pirorin215/btclock/DEVELOPMENT_BACKGROUND.md

# btclock 開発経緯：なぜこのプロジェクトを作ったのか

バイクに搭載する時計に求められるものは何か？
「正確な時間を表示し続けること」という極めてシンプルな要求ですが、市販品や一般的なアプローチにはバイク特有の多くの課題がありました。本プロジェクトは、開発者が繰り返した失敗と、そこから得られた妥協のないこだわりから誕生しました。

---

## 1. 既存のバイク用時計に対する不満と失敗の歴史

### 失敗①：常時電源（バッテリー直結 12V→5V）によるマイコン永続化
一般的なアプローチとして、「イグニッション連動の5Vだけでなく、バッテリーから常時12V（5V変換）を引き込んで時計を永続化する」という方法があります。

私も以前、キーONでLED表示を点灯させ、時計補償用（バックアップ用）に常時電源を引く仕様の市販時計を使用していました。しばらくは快適に使えていましたが、たまにしかバイクに乗らない私にとって、この仕様には致命的なデメリットがありました。微弱な待機電流であっても、長期間放置されることでクロスカブの鉛バッテリーが過放電を起こし、バッテリーの復旧（あるいは交換）に多大な労力を費やすことになったのです。

**「時計のためにバイクのエンジンがかからない」などということは絶対に避けるべき本末転倒な事態です。** 私はその時計を取り外し、その場でジャンク箱へ本当に投げ入れました。

### 失敗②：内蔵バックアップ電池による時刻の永続化
次に試したのは、内蔵電池（コイン電池など）で時刻データのみを保持し、画面はキーONで点灯するタイプのものでした。

今度はバイク自体のバッテリー上がりこそ回避できたものの、数年後に内蔵電池が寿命を迎えました。さらに悪いことに、電池が錆びついて端子を腐食させ、本体ごと使用不能になってしまいました。また、この手のクォーツ時計は数ヶ月で数分の狂いが生じるため、定期的な時刻合わせの手間もストレスでした。

### 失敗③：市販の電波時計
それならと、市販のバイク用電波時計を導入してみました。しかし、今度は「日中の視認性」に問題がありました。液晶が暗すぎて、昼間の走行中にはほとんど時刻を読み取ることができませんでした。そして電池が切れた時、「市販品には本当に満足できるものがない」と確信するに至りました。

---

## 2. 自作への道：初代「GPS-USB時計」

これらの失敗を踏まえ、「10年はノーメンテナンスで動き続けるバイク用時計」を目指して自作したのが、**GPSで時刻を自動修正し、イグニッション連動のUSB電源のみで動作する7セグLED時計**です。

- **常時電源を使わない（イグニッション連動）**：バイクのバッテリーを絶対に上げない。
- **二次電池（内蔵バックアップ電池）を使わない**：電池交換の手間をなくし、液漏れや錆による故障を完全に防ぐ。
- **GPSによる自動時刻合わせ**：起動時にGPS衛星から正確な時刻を取得するため、手動の時刻合わせが不要。
- **7セグLED表示**：日中でも圧倒的な視認性。

このデバイスは、その後**6年間ノーメンテナンス**で動き続けています。

---

## 3. btclockプロジェクトへの進化：本プロジェクトの存在意義

初代GPS時計は素晴らしいものでしたが、以下の新たな課題や改善点が見えてきました。

1. **GPS測位の時間と場所の制限**：ガレージ内や高架下、あるいは起動直後や曇りの日はGPS信号を掴みにくく、同期までに5分以上かかることもある。
2. **日中の視認性の向上**：ePaper（電子ペーパー）を採用することで昼間も見やすくしたい。

そこで、後継プロジェクトとして立ち上げたのがこの **`btclock`** です。

### 本プロジェクトの設計思想（大前提）
本プロジェクトでは、以下の2点を絶対に譲れない大前提として設計しています。

* **「バッテリー直結（常時電源）は行わない」**
* **「二次電池（バックアップ電池）は使用しない」**

### `btclock` で採用したアプローチ
- **Bluetooth Low Energy (BLE) によるスマートフォン連携**
  GPSの代わりに、現代の誰もが持ち歩いているスマートフォンのBluetoothを利用します。イグニッションONで起動したデバイスが、バッグやポケットの中にあるスマートフォンのアプリと自動的に接続し、数秒でミリ秒精度の正確な時刻に同期します。
- **ePaper (電子ペーパー) の採用**
  超低消費電力で、直射日光下でも紙のようにくっきりと見えるePaperを採用することで、「昼間に見えづらい」問題を完全に解決します。
