pirorin215/btclock/TODO.md

# btclock TODO

## 残課題

（現在なし — v1.4.9 様子見は 2026-10-31 にクローズ・完了済み参照）

## 保留

## 完了済み

### 2026-10-31
- [x] **v1.4.9 運用様子見をクローズ**(2026-10-31 ユーザー判断「再発しなさそう」) — スキャン沈黙の再発は観察されていない。**v1.4.10(スキャン停止放置の防御修正: bonded解決空時の10秒定周期再試行+health check 1分毎の「未接続&スキャン停止」検知)は 2026-10-29 14:09 /apk/ 配信済みのまま未適用・再発したら適用で復旧**(Bluetooth OFF/ON でも可)。付随メモ: 2台同時広告時の接続先選択は未観察(設計上どちらか1台に繋がる)・RSSIスライダーの負値保存は符号問題なし(10-29 確認済み)・旧 `target_device_name` は DataStore 残留のまま(未読・害なし)

### 2026-10-29
- [x] **BTClockMob v1.4.9 接続先デバイス選択の廃止・自動接続専用化**(ビルド済み・実機確認待ち) — 自転車/バイクを交互に使うたびメイン画面プルダウンで接続先を手動切替していた問題の解消。プルダウン・設定画面のデバイス選択ラジオ・`TARGET_DEVICE_NAME` 設定キー・`BleScanServiceManager.targetDeviceName`・bonded 直接接続ショートカット(rssiDisconnectPending/lastScanRssi を含む)を削除し、スキャンフィルタを常に「ペアリング済み全 BikeClock- デバイスのOR条件」+「スキャン発見経由の接続のみ」に統一。根拠: 自転車とバイクに同時乗車はない=広告しているのは乗っている乗り物の1台(バイク版はイグニッションOFFで電源なし・cycleclock は切断後1分で System OFF)で、スキャン経由接続は v1.4.x の RSSI 接続しきい値フィルタが必ず通る。ヘッダーは接続中デバイス名(または未接続)表示のみに簡素化。乗降ログはデバイス区別フィールドなし(ride-*.jsonl)のまま=将来乗り物別集計が必要になったら別途

### 2026-10-25
- [x] **BTClockMobにRSSI リンク品質管理**(v1.4.4・端末適用済み・**実機フルサイクル確認済み**: 接続→弱電波(-90dBm)で切断→近接で再接続。時計の接続LEDでユーザー確認) — 自転車レーダー gardia_radar と同じ「RSSI 信号強度での切断/接続制御」を**アプリ側のみ**に実装。**導入動機**: コンビニ/マクドナルド等で駐輪場から移動先が近いと BLE が切れず、接続中=乗車扱いで乗降データが不正確になる実害が 1 ヶ月続いた(レーダー側では RSSI 制御で切れていた)。電力よりもデータ品質の問題が本線。しきい値はアプリのスライダーで調整可なので、マイコン差分(BT電波性能)の調整は実運用で行う・様子見中①接続時フィルタ: スキャン発見時の RSSI が接続しきい値(デフォルト -80dBm)未満なら接続スキップ+再スキャン継続 ②接続中の自動切断(設定 ON/OFF・デフォルト OFF): 5秒ごとに readRemoteRssi、切断しきい値(-90dBm)未満が判定回数(3回=15秒)連続で forceDisconnect ③設定画面に「RSSI設定」セクション(しきい値スライダー×2+判定回数) ④MainScreen ヘッダーにリンク品質の色分け dBm 表示。実装は `BleConnectionManager`(判定)+`BleRepository`(RSSI読み取り)・deviceFoundFlow を `Pair<BluetoothDevice,Int>` に拡張。既存の死リンク検知(SYNC_FAIL_LIMIT)と独立。**ファーム側への実装は誤解→v0.4.24 はリバート済み(cycleclock は v0.4.23 のまま・コード変更なし)**。修正履歴: ①v1.4.1 ヘッダーRow幅不足で RSSI 表示が切れる(デバイス名を可変幅+ellipsis) ②v1.4.1 切断後の即復活: 自動再接続が bonded 直接接続で RSSI フィルタを通らず→RSSI 切断直後は bonded 直接接続をスキップしスキャン発見時に品質を再判定 ③v1.4.2 スキャンレート制限対策: 「スキップ→1秒後再スキャン」が Android の startScan 制限(30秒間5回)に当たりスキャン沈黙→gardia_radar 戦略を移植(スキャン開始 6 秒スロットル+onScanFailed 指数バックオフ) ④v1.4.3 スキャンの `CALLBACK_TYPE` を FIRST_MATCH→**ALL_MATCHES** へ(gardia_radar と同一。FIRST_MATCH はフィルタに最初にマッチした 1 回だけしか報告せず、スキップ後の発見が二度と来ない=「近づいても再接続されない」の第 1 原因) ⑤v1.4.4 発見時の接続許可に **Error 状態を追加**(forceDisconnect は Error のまま残すため、Disconnected のみのチェックだと切断後の発見を「Already connected」で捨てる=第 2 原因)。**設計上の確認事項**: cycleclock は切断後 1 分で System OFF(アドバタイズ停止)なので、RSSI 切断後は時計が寝て近づいても繋がらない=正しい挙動(喫茶店問題の解決)。再接続は振動起床→アドバタイズ→アプリが拾うフロー。しきい値の実運用調整はユーザー実施中(切断 -80/接続 -75 でテスト)・RSSI は両端マイコン(BT電波性能)で変わるため gardia_radar のデフォルト値は初期値

### 2026-10-12
- [x] **BLE分割転送の実装**(cycleclock v0.4.23 + BTClockMob v1.3.0・実機E2E確認済み) — 単一Write 244B制約の解消。プロトコル: 1個目 `NOTIFY:app=<名前>/<総数>\n<パート1>` + 続き `NOTIFYADD:<パートN>`(片方向・Ack/タイムアウトなし・ファームはRAM組立・総数最大8)。ファームは受信バッファ200B→**512B**(日本語約170文字)へ拡大し、能力probe `GET:features`(`OK:features:notifychunk:512`)を追加。**非対応機はprobe失敗で自動的に従来の単一Write**(バイク版ESP32への影響なし)。アプリ側: 接続毎にprobe(BleOrchestrator startFullSync)→`NotificationSplitter` で240B以内・UTF-8境界安全に分割→逐次送信。スライダー上限100→160文字。実装中の不具合1件: Orchestratorの応答ルーティングに FETCHING_FEATURES を追加し忘れprobeがタイムアウト→追加で解消。E2E実測: 88文字(264B)通知が `NOTIFY:app=X/2`(207B)+`NOTIFYADD:`(57B)で60ms間隔に到着→完全組立→3ページ表示。併せてファーム/アプリ双方の UTF-8 末尾トリムの境界バグ(切り詰め境界がCJK文字境界と一致すると1文字余分に削る・60→59文字の原因)を修正。バイク版(bikeclock_esp32)は未対応のまま(動作に影響なし・将来probeに対応させれば分割の恩恵を受けられる)
- [x] **v0.4.22 自動上書き表示中のページ送りregression修正**(ビルド済み/実機書込済み) — ユーザー実機報告「自動上書き表示中はFUNC押下でフラッシュするだけ」を実機ログで特定: v0.4.21が再入判定に使った ep_drawnMode は、時計上書き表示中も updateEpaperDisplay のTIMEモード入口で**毎ループパス TIME に戻る**(通知ビュー描画時に NOTIFICATION を設定しても次パスで clobber)ため、notifyPageAdvance の再入判定が誤発火し毎回1ページ目へ戻っていた。モード2では非TIME分岐が先に return するため無事だった(ログで裏取り済み)。修正: 専用フラグ `ep_notifyOnScreen`(描画時に立てる・invalidateViewCache と詳細/詳細大への遷移で解除)に置換し、無意味化していた自動上書き側の ep_drawnMode 代入は削除。adb cmd notification post で投稿した60文字テスト通知(2ページ構成)で検証
- [x] **表示されている「文がシャッフルされて見える」件の切り分け(ファーム無罪)** — ユーザー報告「1ページ目が『今から喜ぶのは〜』で始まり2ページ目に『ラバルのやつが』が出る」。実機ログの受信本文を確認したところ、**アプリが送った時点でその並び**(fastrecmob 通知の title+body 結合 = 動画タイトル前半 + チャンネル名部分 + 別断片、180B で切断済み)。ファームのページ分割・描画は受信テキストに対して正しく、表示順の怪しさはアプリ側の結合順と本文内容に起因
- [x] **通知転送の実効上限を実測確定**(adb cmd notification post で5段階テスト) — Pixel 10 へワイヤレス adb 接続し `cmd notification post -S bigtext`(実通知パス=BikeNotificationListener の切り詰めを通る)で送信、ファームログで受信値を確認: **日本語は 60文字(180B) が上限**(60文字→180B 無切断・100文字→177B/59文字にサイレント切断。スライダー100文字は CJK には効かない。ASCII は 100文字=100B でスライダー上限が効く)。60文字→5行→**2ページが現プロトコルの最大**(MTU 247→Write 244B→ヘッダ差引き本文180B の設計上限)。副次発見: アプリ truncateUtf8 は 180B 境界が CJK 文字の完全一致になる場合も1文字余分に削る off-by-one(60→59文字)。監視は nohup consolelog(/tmp/cc_console.log)で恒久化。今後の拡張は分割転送プロトコル(アプリ+ファーム改修)のみ
- [x] **通知ビュー再入時の先頭ページ復帰**(v0.4.21・ビルド済み/実機書込済み) — v0.4.20では前回の読書位置(ページ)が保持され、再び通知ビューを開くと最終ページから出るというユーザー指摘を修正。他ビューからの再入(モード2再選択・時計上書きの再表示)では ep_drawnMode != NOTIFICATION を根拠に先頭ページへ戻す。時計上書き表示が画面に出ていることを ep_drawnMode=NOTIFICATION で示すようにし(単一ページ通知の状態で FUNC→モード2 した際の無駄なフル更新も自然に抑制)、ページ送りの直接描画との区別がつく。実機書込済み・シリアル起動ログで `Firmware Version: 0.4.21 (Oct 12 2026)` 確認
- [x] **通知本文の見切れ原因の特定(アプリ側の仕様だった)** — ユーザー報告「2ページ目で切れる」。ファームの200B上限ではなく **BTClockMob 側で2段階の切り詰め**が発生していた: ①設定「通知転送の最大文字数」デフォルト **47文字**(超過時は末尾に「＞」を付与・スライダー10〜100文字で変更可・`DEFAULT_NOTIFICATION_MAX_CHARS`) ②UTF-8 **180B** ハード上限(`MAX_BODY_BYTES`・"NOTIFY:app=<pkg>\n" ヘッダ込みでMTU 247に収めるため。日本語≈60文字が実効上限・こちらは「＞」なしのサイレント切断)。対処: ページング運用ではアプリ設定のスライダーを上げる(日本語主体なら実効上限の60文字・ASCII混在なら100文字まで有効)。デフォルト値の引き上げ(アプリ改修)は未実施
- [x] **通知ビューのページ送り**(v0.4.20・ビルド済み/実機書込済み・ユーザー動作確認) — ePaper が狭く長文通知が見切れる問題への対処。FUNC クリックの割当を競合させないため「ロールオーバー方式」を採用(専用キー増設案は D3 が BMI160 I2C 予約のため見送り): **通知ビュー(モード2・時計への新着自動上書き)表示中は FUNC クリック=次ページ**、最終ページで合流(モード2=そのままモード順送り/時計上書き=通知を閉じて時計へ=読了)。1ページに収まる通知は従来どおり FUNC=モード循環。実装: 旧 drawWrappedText を行境界生成(wrapTextLines)+行範囲描画(drawTextLines)に分解し ep_notifyPage の範囲のみ描画、複数ページ時は下端 14px に「n/m」帯を確保(帯分は行数計算から予約・単一ページは全高のまま旧表示と同一)。ページ送りのたびに 30 秒通知ウィンドウと 10 秒自動復帰を延長。**時計への自動上書き表示も新着受信(seq)で再描画するよう拡張**(旧実装は表示中の新着が画面に反映されず)。Flash 84%/RAM 10%

### 2026-10-07
- [x] **System OFF 22µA 達成(BSS138 ローサイドで ePaper+WS2812B 統合切断)** — 実機に BSS138+100kΩ を組み込み、**ePaper の GND と WS2812B の GND を同じ BSS138 の D へ共有接続**(VCC/VDD は 3V3 直結のまま)。360µA→**22µA**(94% 減・安定まで数十秒かかるのはコンデンサ放電で正常)。動作確認: LED 点灯・通知演出・ePaper スリープ残画・振動復帰すべて正常。待機電流の内訳: XIAO 11µA+ePaper 残存 ~8µA+WS2812B 残存 ~3µA。**懸念だった DIN の 10kΩプルダウン経由の迂回リークは実測でほぼ出ない**(WS2812B の DIN 入力が高阻抗のため)。ファームは v0.4.19 のまま(D1=HIGH 制御が v0.4.10 から生きており BSS138 と同一論理)。電池寿命: 年間 ~900mAh(毎日乗車想定)=3 年超
- [x] **360µA の切り分け(WS2812B が主犯と判明)** — BSS138 組込直後の実機が 360µA までしか下がらず。①ローサイドの構造的限界(VCC 残存×信号線迂回)を疑ったが、②**WS2812B の VDD(3V3 直結)を外すと 22µA** まで下がり主犯確定(~330µA スタンバイリーク)。ePaper のローサイド残存は ~17µA でほぼ完璧に機能していた。→ GND 共有接続で解決
- [x] **BSS138 単体動作試験(マイコンなし)+ kento 資料化** — 安定化電源 3.3V+負荷 500Ω+100kΩプルダウンで 3 状態測定。**RDS(on) 実測 ≈2.6Ω**(ON 時 VDS=17mV・6.57mA・規格 3.5Ω@4.5V 以内)で合格・採用確定。フル更新 50mA でも GND 浮き 0.13V で SSD1680 動作範囲内。教訓: ①ワニ口クリップ 1 個の接触不良で数十Ω乗る(mV 級測定は全固定+プローブはリード根元直当て) ②ゲートジャンパ接触不良は「部分導通」という紛らわしい症状になる(先に G-S 電圧を疑う) ③**実機組込前に単体で足場を作る=昨日の TPS22810 敗北(基板に組んだ瞬nectに何が悪いか分からなくなる)の再発防止**。記録: `~/www/kento/bss138-epaper-lowside-switch.html`(実機組込配線・AO3401A 移行手順込み)
- [x] **部品台帳の写真棚卸し(実店舗購入品の取り込み)** — Pixel 撮影→NAS(`/data/share/photos`・Syncthing 同期)→rsync→**vocr 識別→13 品目登録**(MCP3008×2/MCP23017/MCP23S17/MCP23S08/74HC595/AE-XCL103-3V3/AE-SPU0414/GY-GPS NEO-5M/LCD1602 キット/ブザー 3-24V/XY-UP/Azoteq TPS43-201A/シリカゲル・seed076-088・台帳 89→102 品)+BSS138 ×8(seed075)。不明 3 件はユーザー指示で未登録。フローは手順化されメモリ保存済み(次回「棚卸し」で即回せる)

### 2026-10-06(2)
- [x] **v0.4.18 シリアル調整コマンド実装**(ビルド済み・書込待ち) — WS2812B の常亮色をシリアルから調整する調整段階専用UI: `led R G B`(即変更+BLE未接続でもプレビュー点灯)/`ledsave`(InternalFS `/ledstrip.bin` へ永続化)/`leddefault`(保存削除・既定値へ)/`ledflash R G B`(演出プレビュー)/`ledinfo`。コマンド受信のたびにスリープ判定を延長(未接続の調整作業が1分System OFFに潰れない)。シリアル処理はloop文脈のみ(InternalFS書込みをBLEコールバックから触らない設計を維持)。Flash 84%/RAM 10%
- [x] **WS2812B 点灯確認**(ユーザー報告・v0.4.16/17) — 配線(DIN→D6+10kΩプルダウン・VDD→3V3分岐)で点灯・三色制御確認済み
- [x] **v0.4.16/17 WS2812B 装飾LED 実装**(ビルド済み・配線待ち) — `cycleclock_ledstrip.ino` 新設。VDD は XIAO 3V3 から分岐(3.3V 駆動・System OFF 中も通電のため DIN 10kΩプルダウンで消灯維持)。D6 は起動シーケンスの早い段階で LOW 出力へ確定(`setupLedStrip()` を `setupEpaper()` より先に呼び DIN 浮き誤点灯防止)。送信は Adafruit_NeoPixel(nRF52 は NRF_PWM+EasyDMA・SoftDevice 割込でもビット時序が壊れない・~/dev/Arduino/libraries 既存を使用)。演出は loop 駆動の非ブロッキング状態機。System OFF 直前は消灯ラッチ送信→D6 INPUT 化。Flash 83%/RAM 10%
- [x] **v0.4.11 実装・ビルド**(書込待ち) — 誤起動回数(フラッシュ永続化)+D0短絡回数(processWakeSwitch 押下開始と同タイミング・BT接続中のみ)+詳細画面表示。Seeeduino nRF52 では InternalFS は `InternalFileSystem.h`(InternalFileSytem ライブラリ・bonding と同じ)/File 型は `Adafruit_LittleFS_Namespace::File`/open モードは `FILE_O_READ/FILE_O_WRITE` を使う(ビルド教訓)
- [x] **喫茶店問題の原因特定**(ユーザー推理による) — 「スマホが近くに居ると cycleclock が寝ない」問題。TR70(Gardia)が喫茶店で「切断されてた/戻ると再接続」に見えたのは TR70 の仕様ではなく、自作ガリアアプリ(`~/dev/Android/gardia_radar`)の **RSSI しきい値接続制御**(デフォルト -80dBm 未満で接続スキップ+再スキャン)だった。解決策=BTClockMob に同じ仕組みを移植(残課題へ)
- [x] **TPS22810 ノイズ問題の切り分け完了** — v2.2d(連続フル更新+D1監視)で EN(D1)は最後まで HIGH=SPI/MISO 競合説を否定。RON@3.3V=83mΩ(datasheet)で能力問題も否定→チャージポンプのスイッチングノイズが ePaper フル更新と相性不良と結論。VOUT 10µF 添加で初回表示まで改善したが2回目以降ダメ→撤退を決定(P-ch MOSFET へ)

### 2026-10-06
- [x] **通知ビューのアプリ名行廃止**(v0.4.11・ビルド済み/書込待ち) — アプリ名の常設先頭行(16px+本文y=24開始)が本文エリアを圧迫し4行目が切れるため廃止。本文のみを y=0 から全画面描画し、全文が4行収まるように。本文が空の時だけアプリ名を代替表示(両方空なら従来どおり「通知なし」)。g_notificationApp はログ用として維持(BLE送信側・アプリ互換は無変更)
- [x] **System OFF 0.5mA 問題 完全解決(TPS22810 ロードスイッチ導入・実測11µA)** — µAテスタ初実測で発覚した待機電流0.5mA(推定電池寿命60日)を11µA(約31年・自己放電支配)まで削減。切り分けの経過: ①本番v0.4.9=0.5-0.6mA ②最小ファーム+hibernate+信号Hi-Z化=630µA(効果なし) ③ePaper VCC外し=27µA ④新品XIAO裸=11µA(基準値) ⑤**TPS22810でePaper VCCをGPIO制御→11µA(完全解決)**。真因は ePaper モジュール基板(信号線プルアップ+レベルシフタ)への常時給電で、ファームウェア(hibernate・Hi-Z化)では断てなかった。**教訓: ①SOT-23-6 の GND 足が欠けると中間電圧(1.25V/2.4V)が出る ②配線の品質自体がµA級のリーク差(27µA→11µA)を生む ③µA 測定はテスタのバイパス方式(テスタ並列にショートリード・起動時のみバイパス)が実用的**
- [x] **診断ファーム `cycleclock_diag/` で切り分け実施** — v0.4.90(本番コピー+10秒スリープ)→ v2(最小3秒スリープ)→ v2.1(信号ピンHi-Z化)→ v2.2(TPS22810制御)→ v2.2b/c(タイムスタンプ+D1 readbackログ+USB列挙待ち2.5s)→ HOLD版(D1=HIGHで永久待機=電圧測定用)。新作ボード(現行)は SoftDevice 未焼きで arduino-cli DFU が不通→UF2(uf2conv)で sd+bootloader 0.6.2+s140 7.3.0 を焼いて解決。テスタ(AN8008)運用ノウハウ: µA系レンジ(VΩ端子)は負担電圧が大きく起動電流でマイコンがブラウンアウト→バイパス方式で回避。6000µAマニュアル固定でも起動不可(実測)

### 2026-10-05
- [x] **振動センサー調整用テストファーム `cycleclock_vibetest/` 作成**(ビルド済み・書込待ち) — D0 導通(振動パルス)でオンボード緑 LED 点灯・導通解除後 1 秒で消灯(連続振動中は点きっぱなし)。検出は本番(v0.4.8)と同じ GPIOTE 割り込み(CHANGE で両エッジを受け導通幅 µs 測定も追加)+Serial 統計ログ(300ms 窓のパルス数・導通幅・5 秒 HB)。BLE/ePaper/System OFF は意図的に非搭載(調整中に寝ない・USB 駆動推奨)。本番と同じ D0 で調整結果はそのまま転用可。ビルドノウハウ: Serial(USB CDC)の実体は bluefruit.h の依存検出で間接リンクされていたため、BLE なしスケッチでは `Adafruit_TinyUSB.h` の明示 include が必須(無いとリンカで Serial 未定義)
- [x] **v0.4.9 実機確認**(ユーザー確認OK) — ①未同期画面のバージョン表示でv0.4.9を確認 ②BLE接続中は3分無振動でも寝ない ③切断後は無振動3分経過済みなら即System OFF ④D0の2秒導通で寝ない(長押し廃止の確認) ⑤FUNC非TIMEモード10秒自動復帰 ⑥通知30秒表示 ⑦フル更新の体感速度(BW版・ユーザー報告「一瞬で書き換わる」)。書込はUSB経由(3回ともDevice programmedまで成功・シリアル起動ログはCDC再列挙で未捕捉だったため画面で確認)
- [x] **BW版ePaper 実機差替**(2026-10-05・ユーザー実施) — 物理差替完了。フル更新の高速化はユーザー報告「一瞬で書き換わる」で確認。ファーム側はv0.4.9で3色低速前提コード撤去済み(waitPanelIdle 30秒ガード廃止・FUNC自動復帰60秒→10秒・通知60秒→30秒=いずれもbikeclock_esp32と同一)。描画コードにGxEPD_RED等の3色名残は無し(BW駆動のまま)
- [x] **スリープポリシー変更+BW版前提の整理**(v0.4.9・実機確認済み) — ①BLE接続中はスリープしない(checkSleepTimeout冒頭でガード・切断後は無振動3分経過済みなら即System OFF。旧「接続中でも先に切断して寝る」分岐は削除) ②D0長押し2秒の手動System OFFを廃止(測定・テスト用だったが無振動3分放置で代替可) ③System OFF前の解放待ち10秒上限を廃止し導通が解けるまで無期限に待つ(短絡時に打ち切って寝ると即再起床の再起動ループ→ePaperフル更新連発で電池を食うため) ④BW版ePaper前提へ: waitPanelIdle(3色パネルの>10秒フル更新対策ガード)廃止・FUNC自動復帰60秒→10秒・通知表示60秒→30秒(いずれもbikeclock_esp32と同一)

### 2026-10-04
- [x] **振動パルス検出の実機確認**(v0.4.8) — GPIOTE割り込み(FALLING)化で動作確認(2026-10-04・ログ出力を確認)。v0.4.6以前の50msデバウンス・v0.4.7のloopポーリング(約10ms)はいずれも1ms級の導通パルスを取りこぼしていた(起床はDETECTが拾うが延長が発火しない)。SW-18020P自体の感度は「強いショックには確実・微振動に弱い」で、代替素子調査(SW-200D/520D=チルト検知で不適・SW-420=常時mA消費で不適・18010P/15P=バネ式で導通品質良いが微振動感度は下がる実測)の結果、当面現状維持+実走行で様子見。改善するなら異機構2素子のD0並列接続が有望(受動・ゼロ消費のまま)
- [x] SW-18020P 組込 — タクトスイッチと差し替え(D0・結線同じ他端GND)。2026-10-04組込済み(ユーザー実施)

### 2026-09-30
- [x] **FUNC4モード実機動作確認**(v0.4.1・2026-09-29ユーザー確認「バッチリ」) — FUNC4モード循環・FUNCキーでのSystem OFF復帰・起床release分離・60秒自動復帰・未同期画面ver表示
- [x] **v0.4.4 書込と実機確認**(omp整理の取り込み) — ①時計遅れ修正の効果(ePaperフル更新を跨いでも時刻が遅れない) ②通知ビュー先頭行のアプリ名 ③FUNC各モード・FUNC起床が従来どおり。後続のv0.4.8実機確認(2026-10-04)・v0.4.9実機確認(2026-10-05)で包含確認済みとして完了扱い
- [x] **omp simplify差分のレビュー・取り込み**(v0.4.4・ビルド済み/書込待ち) — 実質改善: ①updateTimestamp()一括秒加算+端数繰り越し(旧は1呼び出し最大+1秒・端数破棄で、3色パネルのフル更新>10sのたび時計が数秒ずつ遅れ蓄積) ②通知ビュー先頭行にアプリ名表示(従来ログ専用) ③BLE過大Write(>247B)へERROR応答 ④BLE切断reasonログ化。整理: デバウンス共通化(DebouncedSwitch)・isLeapYear抽出・モード分岐switch化・invalidateViewCache()・コールバック名onConnect化・未使用define削除・LEDコメント実態化。**日跨ぎ走行区間の折り返し表記化はompによる勝手な仕様変更と判定し原状回復**(24時超え表記「22:00〜26:30」=bikeclock_esp32と同一仕様・getRideStartとの共通化を解除)
- [x] **FUNCキーでのSystem OFF復帰**(v0.4.1・実機確認済み) — enterSystemOff のウェイクピン構成にD2を追加(nRF52のDETECTはピンごとSENSE条件のOR・どちらかの導通で起床)。FUNC押下で起床した場合の初回releaseはモード切替としない(起床操作と切替操作の分離・起動時のピン読みで推定)。System OFF前のスイッチ解放待ちをD0/D2両方に拡張(FUNC押しっぱなし放置でも即再起床ループを防止)
- [x] **FUNCモードをbikeclock_esp32と同一の4モード構成へ**(v0.4.0・ビルド済み/書込待ち) — ユーザー要件「bikeclock_esp32とほぼ一緒に(バッテリーピクト追加した形)」。モード1時計/モード2通知(最終受信・手動選択・新着g_notificationSeqで再描画)/モード3詳細(開始/経過/現在日時/電池電圧・esp32のHID行の代わりにバッテリー行)/モード4詳細大(日付/経過/開始〜現在+ピクト・スリープ残画と実体共通のdrawEpaperDetailLarge)。電池詳細・バージョンの独立モードは廃止。起動時刻はスリープ残画と同じ逆算方式(現在−経過)。追伸要件: 未同期画面(同期まで数分見続ける)にver表示を追加
- [x] **FUNCキーを専用GPIO(D2)へ分離**(v0.3.9・ビルド済み/書込待ち) — v0.3.8の押下時間分離(D0中押し0.5-2s=モード切替)は実機で不採用: クリックで反応せず・長押し操作が使いづらく・そもそも走行中は振動が常にD0へ短押しパルスを入れるため「単押し=モード切替」と要件が排他。波形学習で振動/人間を判別する案は論外として、空きGPIOがあるなら分離一択(bikeclockが専用FUNCキーSW8を持っていたのと同じ理由)。D0は純粋な振動ウェイクに戻し、D2クリック=モード順送り(bikeclock同様)・60秒自動復帰と乗車イベント復帰の自己修復は維持
- [x] **FUNCキー機構の移植**(v0.3.8・ビルド済み/書込待ち) — bikeclock の FUNCキー(SW8短押しでTIME/DATE/WEEKDAY循環+5s自動復帰)を cycleclock へ移植。相違点: cycleclock のスイッチは振動センサー兼用のため押下時間を3段階に分離(短<0.5s=乗車イベント/中0.5-2s=モード切替/長≥2s=System OFF)。モードは時計→電池詳細(電圧大表示+ピクト・電圧変化で再描画)→バージョン。60秒自動復帰+乗車イベントで復帰の二重自己修復(振動誤切替の被害を限定)
- [x] **電池表示の閾値・段階スイープ試験**(v0.3.7実機で実施・安電源コールドブート毎) — 3.5V=要充電ビュー/3.6-3.7V=1本/3.8V=2本/3.9V=3本/4.0V=4本/4.1V=5本。設計式(level=(V-3.60)/0.1+1・≥4.00Vで満枠)と0.1V精度内で整合(「4.0V表示で4本」は実出力3.96-3.99V想定)。実18650: 3.77V→2本(計算一致)。ePaper書換の急激な電圧低下にピクトは反応せず安定(BUSYガード+中央値フィルタの効果)。残すは `BATT_DIV_MULT` 校正(ソーラー実機確認と同時)
- [x] **残量表示の中央値フィルタ**(v0.3.7・書込済み。書込はユーザーが手動実施) — 直近5サンプル(5分)の中央値を表示・報告値(`s_battVolts`)に採用。ピクトが表現すべきは「残量」=弛緩電圧で、負荷dipの単発ノイズは無視する設計(実際の放電はゆっくりなので実変更には5分以内に追従)。ログはraw+フィルタ後の両方。v0.3.6のパネルBUSYガードと重ねて二段構え。USB-only電池なし構成では測定自体が無意味な件は仕様メモに記載(Plan BのVBUS検知は未実装・必要になり次第)
- [x] **パネルBUSY中の電圧測定スキップ**(v0.3.6・書込済み) — display()がBUSYタイムアウト(10s)で先に返った後も3色パネルは物理更新を続けるため、直後のloopで走るupdateBattery()が負荷スパイク中に測定してキャッシュを汚染していた(スリープ残画のピクトが時計より低く描かれる一因)。`epaperIdle()`(setupEpaper完了までは常時idle扱い)でBUSY=HIGH中はスキップ。fastrec2の「アイドル時キャッシュ測定」教訓を実装として強制
- [x] **「時計5ピクト→スリープ1ピクト」の原因特定** — 時計はブート時キャッシュ(4.082V・無負荷測定)で描かれ、60秒後の接続負荷下実測(3.70V)がキャッシュされてからスリープ残画が描かれたため。両表示ともその瞬間のBATパッド電圧としては正しい。真因は安電源のCC制限による負荷時電圧崩落(上記残課題)
- [x] **「ピクト1/5なのにアプリ4.08V」の原因判明**(誤動作なし) — デバイス実測は3.69-3.73Vでピクト1本は正しく、アプリ表示は16:56ポーリング(v0.3.4書込直後の4077mV)の古い値が残っていたもの。5分間隔ポーリングがスリープ中に不可能なため更新されず+ePaper残画がスリープ前フレームを保持していた時間差現象。ピクト/GET:batteryは同一キャッシュを参照し常に一致
- [x] **電池ピクトの右下固定+スリープ残画対応**(v0.3.5・書込済み) — 横型から縦型(端子上・バー下から積み上げ)へ変更し画面右下(222,86)に固定。時計画面は乗車時間を右端242→206へオフセット+時計アイコンをcx136→90へ移動して右下に場所を空けた(横型のままだとアイコン+数字+ピクトが右欄176pxに収まらないため縦型化)。スリープ画面(残画)にも同じ位置に描画→System OFF中も翌日まで電池量が見える(「寝てる時こそ観たい」要望)。警告「!」はピクト左に両ビュー共通で表示
- [x] **時計画面の電池ピクトグラム+警告「!」**(v0.3.4・書込済み) — 右欄下段左の空き領域(乗車時間アイコンの左)に横型5段階バッテリー(3.60-4.10Vを0.1V刻み・<3.60Vは0本の空枠・>=4.00V満枠)。3.65V未満でピクト左に「!」(解除3.70Vのヒステリシス・ePaperは点滅不可のため静的マーク)。段階は `batteryLevelPict()`、警告は `batteryWarnActive()` ラッチ。描画は毎分の時計更新に乗る(電圧変化の反映は最大60秒遅れ)。書込直後4.08Vで5本満枠を確認(視覚は安電源掃き試験で要確認)
- [x] **要充電ビューの3.5V実機確認**(v0.3.3) — 安定化電源3.5V駆動で全画面「要充電」が表示されることを確認。過放電防止のためこの全画面状態が必要と判断(ユーザー評価)
- [x] **低電圧通知のePaper表示 実装**(v0.3.3・ビルド済み) — 3.50V以下で「要充電」ビュー(電池アイコン+実測電圧)、3.60V以上で解除のヒステリシス(`BATT_LOW_THRESHOLD_V`/`BATT_LOW_CLEAR_V`)。ビュー優先度は 通知>低電圧>未同期>時計。スリープ時は乗車スナップショットの代わりに要充電を残画化(駐輪〜翌日も警告が見える=充電忘れ防止が主目的)。発報は60秒キャッシュ測定側のラッチ(`batteryLowActive()`)で行い、ADC非接触の設計(lesson: BLEコールバックからのSAADCアクセス禁止)は維持

### 2026-09-27
- [x] **配線組立**(2026-09-27完了) — kentoメモ(`~/www/kento/xiao-ble-solar-tp4056.html`)の組立手順どおり: パネル→IN± / 18650→B± / XIAO電池パッド→OUT±。検品・パネル確認・Rprog・ベンチチェックの結果は未記録(下記実機確認で総合的に判断)
- [x] **スマホ通知のePaper表示**(cycleclock v0.3.2・実機確認済み) — バイク版(bikeclock_esp32 Phase 10/11)と同じ仕組みを移植。アプリの通知リスナーが `NOTIFY:app=...\n本文`(最大200B)を送り通知ビューを表示。これまで表示されなかった原因は3つ: ①コマンド特性が32B固定長で長Writeが届かない ②NOTIFY:ハンドラ不在 ③通知ビュー移植時削除。対応: ATT MTU 247拡大+特性可変長247B化・handleNotify移植・通知ビュー(文字数フォント段階切替+日本語自動折返し)復活。60秒表示→時計へ自動復帰(3色パネルの低速フル更新を考慮しesp32版30秒から延長)。アプリ側変更不要(MTU 517要求・通知リスナー・デバッグ画面は実装済み)。実機確認: 書込直後にXの通知が届きePaperに表示されるのを確認(初回実通知で確認・デバッグ画面未使用)
- [x] **ソーラー補助充電の配線組立** — kentoメモ(`~/www/kento/xiao-ble-solar-tp4056.html`)の組立手順どおり: パネル→IN± / 18650→B± / XIAO電池パッド→OUT±

### 2026-09-26
- [x] **スリープ画面が描かれない不具合修正**(v0.3.1・実機確認済み) — 停車すると約3回に1回、詳細表示に切り替わらないまま時計表示で眠っていた。原因: 3色パネルのフル更新がB74ドライバのBUSYタイムアウト(10s固定)より長く、分更新の物理更新中にスリープ画面のコマンドを送ると無視されていた。全フル描画の前にパネルidle待ち(`waitPanelIdle`・上限30s)を追加。あわせてSystem OFF前のスイッチ解放待ちに10sタイムアウト(導通継続時の永久ハング防止・SW-18020P組込前の保険)
- [x] **振動ベーススリープ**(v0.3.0・実機動作確認済み) — 「最終振動(スイッチ導通)から3分」でBLE接続中でも切断してSystem OFF。スマホが近くにいても確実に眠る(自宅・近距離座り込み問題を解決)。実機で「3分でスリープ画面→System OFF」を確認
- [x] **LEDの低消費化**(v0.3.0) — 常時点灯系は超低デューティPWM(約1.2%)、点滅系は2秒に1回50msの短パルス(自作キーボード方式・エラー時500ms間隔)
- [x] **バッテリー電圧の取得・アプリ集計**(v0.2.2で動作確認済み) — 内蔵分圧(P0.31/P0.14)で60秒キャッシュ測定+起動直後即測定、`GET:battery` プロトコル。アプリは接続直後+5分ごとに取得しDataStoreに時系列保存(最大10000件)・ヘッダーに最新電圧表示。実機で取得→保存→表示まで確認(USB充電中4.09V/バッテリ運用3.77V)。修正履歴: ①起動直後の初回取得失敗→即測定化 ②固定長32B特性の応答に残バイトが混入し解析が無音失敗→ファーム側ゼロクリア+アプリ側正規表現解析
- [x] **BTClockMob 新APK適用**(ワイヤレスデバッグで修正版を適用済み) — 複数デバイス対応+バッテリー集計込み
- [x] **実機組立・動作確認** — 書込・ePaper表示・Androidペアリング・時刻同期が一発で動作
- [x] **スリープ時スナップショット表示**(v0.1.5) — System OFF直前に「日付+曜日/乗車時間/走行区間」を描画しゼロ電力で保持。停車中に時刻と勘違いさせない(ESP32版でモーション学習が必要だった課題が、スリープ=ソフトウェアイベント化により自明に解決)
- [x] **System OFF手動テストの安定化**(v0.1.4) — 押下中のDETECT即成立による即時起床(見かけ上の再起動)を回避: スイッチ解放待ち+起床要因ログ(RESETREAS.OFF)追加

### 2026-09-25
- [x] **cycleclock v0.1.0 実装** — 新規 `cycleclock/`: XIAO BLE + WeAct 2.13" ePaper + System OFF振動(タクト)ウェイク。bikeclock(XIAO・BLE/時刻処理)とbikeclock_esp32(ePaper描画)から移植
- [x] **BTClockMob 複数デバイス対応** — 接続先未選択時、ペアリング済みBikeClock全台にスキャンフィルタを掛け実際に広告しているデバイスへ自動接続(バイク/自転車の切替がアプリ操作不要に)。選択時は従来どおり1台限定(後方互換)
- [x] ボード選定: **XIAO BLE (nRF52840)** — System OFF実測2.4μA(管理された計測)・fastrec2の電池運用実績・BLE実績はbikeclockにあり
- [x] 電源方針: 18650をバッテリー端子へ直結 — 給電源が存在しないため内蔵電池で自立。充電/交換のメンテは低電圧通知で運用
- [x] 動作モデル: 乗車時のみ稼働 — バイク版(キーオン→コールドスタート→BLE同期・8年ノーメンテ実績)と同じ寿命モデルを振動ウェイクで再現
- [x] 5V UPSブースト基板(Walfront・18650用)は不採用 — 5Vを必要とする部品がない・二重変換が無駄・5V給電ではXIAO BLEのスリープ電流が下がらない実測あり
- [x] 電動アシスト自転車の走行用バッテリーからは給電しない — 保証・バッテリー消耗の懸念
- [x] ハブダイナモ非搭載のため給電系(発電)案は消滅
- [x] 給電はマイコンボードのバッテリーパッド直結 — XIAO BLE・ESP32-S3 SuperMini とも背面にBAT+/BAT-端子+オンボード充電器あり

## 概要

自転車搭載版の新規製作。バイク版と同様の「乗車時のみ動作」(スマホBLE同期・非乗車時はほぼゼロ消費)を、キーオン電源の代わりにバッテリー直結+振動ウェイクで実現する。ファームウェアは `cycleclock/`(v0.4.23・2026-10-31 実測 cycleclock.h)。設計思想の経緯は DEVELOPMENT_BACKGROUND.md 参照。
