pirorin215/btclock/bikeclock_esp32/bikeclock.h

#define BIKECLOCK_H
#include <Arduino.h>
#include <TM1637Display.h>
#include <LittleFS.h>
#include <U8g2_for_Adafruit_GFX.h>
#define FIRMWARE_VERSION_MAJOR 2
#define FIRMWARE_VERSION_MINOR 0
#define FIRMWARE_VERSION_PATCH 61
#define LED_DIO_GPIO     6   // TM1637 DIO
#define LED_CLK_GPIO     7   // TM1637 CLK
#define SWITCH_SW1_GPIO     41  // Right Arrow (旧GPIO4 → 背面端子)
#define SWITCH_SW2_GPIO     47  // Down Arrow  (旧GPIO5 → 背面端子)
#define SWITCH_SW3_GPIO     13  // Up Arrow
#define SWITCH_SW4_GPIO     14  // Left Arrow
#define SWITCH_SW5_GPIO     35  // Enter
#define SWITCH_SW6_GPIO     38  // Back
#define SWITCH_SW7_GPIO     39  // Play/Pause
#define SWITCH_FUNC_GPIO    8   // Function / Mode / Maintenance
#define HID_DEBOUNCE_DELAY_MS     50   // Switch debounce delay
#define FUNC_SAMPLE_MS          5    // デバウンスタスクのサンプリング周期(ms)
#define FUNC_DEBOUNCE_SAMPLES   8    // 連続一致回数(8×5ms=40ms安定で確定)
#define FUNC_LONGPRESS_MS       2000 // 長押し判定 → メンテナンスカウントダウン
#define EPAPER_FUNC_COALESCE_MS 250  // FUNC連打中のePaper描画遅延（最終モードを1回だけ描画）
#define DEFAULT_SW1_KEYCODE    0x4F  // Right Arrow
#define DEFAULT_SW2_KEYCODE    0x51  // Down Arrow
#define DEFAULT_SW3_KEYCODE    0x52  // Up Arrow
#define DEFAULT_SW4_KEYCODE    0x50  // Left Arrow
#define DEFAULT_SW5_KEYCODE    0x28  // Enter
#define DEFAULT_SW6_KEYCODE    0x0224  // Back (Android)
#define DEFAULT_SW7_KEYCODE    0xCD  // Play/Pause (Consumer Page)
#define ONBOARD_LED_GPIO    48
#define EPD_CS_GPIO         1
#define EPD_DC_GPIO         2
#define EPD_RST_GPIO        3
#define EPD_BUSY_GPIO       10
#define EPD_SPI_SCK_GPIO    12   // 専用 SPI3_HOST
#define EPD_SPI_MOSI_GPIO   11   // 専用 SPI3_HOST (MISOはePaper不要)
#define IMU_SCL_GPIO       4    // SW2 から再利用
#define IMU_SDA_GPIO       5    // SW1 から再利用
#define IMU_I2C_ADDR       0x68 // BMI160 I2C アドレス (SDO→GND で固定)
#define IMU_DEBUG_DUMP     0
struct ImuSample {
    int16_t ax, ay, az;   // 加速度生LSB
    int16_t gx, gy, gz;   // 角速度生LSB
};   // 12B/サンプル
#define IMU_RING_BUFFER_SIZE    500                  // 50Hz × 10秒
#define IMU_SAMPLES_PER_CHUNK   18                   // チャンクあたりサンプル数（ヘッダ5B+216B=221B）
#define IMU_DUMP_INTERVAL_MS    100                  // IMU_DUMP チャンク送信間隔(ms)・dumpIMU シリアル絞りも共通。旧実装は imu.ino で 100 へ再定義しており 30 は死んでいた（再定義で後者が勝つ）
#define IMU_DUMP_MAGIC0         0xAA                 // チャンクマジック上位
#define IMU_DUMP_MAGIC1         0x55                 // チャンクマジック下位
#define IMU_DUMP_STATUS_MORE    0x00                 // status: 継続
#define IMU_DUMP_STATUS_LAST    0xFF                 // status: 最終チャンク
#define IMU_DUMP_MAX_RETRY      5                    // チャンク送信失敗時リトライ上限
#define IMU_RECORD_DURATION_MS  4000UL               // IMU_RECORD_START: 4秒録音後に送信
#define IMU_DUMP_CHUNK_HEADER   5                    // magic(2)+seq(1)+total(1)+status(1)
#define MOTION_MODEL_FILE_PATH   "/motion_model.bin"
#define MOTION_FEAT_DIM          21                  // 特徴量次元（Android と共通）
#define MAX_MOTION_PATTERNS      12                  // 保持上限
#define MOTION_NAME_LEN          16                  // パターン名バッファ
#define MOTION_INFER_INTERVAL_MS 500UL               // 推論周期（窓短縮に伴い 1秒→0.5秒）
#define MOTION_FEAT_WINDOW_SAMPLES 100               // 特徴量抽出窓長（50Hz×2秒=100サンプル）。Android MotionFeatures.WINDOW_SAMPLES と一致させること
#define MOTION_DISTANCE_THRESH   0.5f                // 最近傍距離の閾値（スケール正規化空間）。超過は「不明」。実機調整
static const float MOTION_FEATURE_SCALE[MOTION_FEAT_DIM] = {
    1.0f, 1.0f, 1.0f,    // accDyn max x/y/z（符号付きピーク・行き方向）
    1.0f, 1.0f, 1.0f,    // accDyn min x/y/z（符号付きピーク・戻り方向）
    1.0f, 1.0f, 1.0f,    // accDyn rms x/y/z
    20.0f, 20.0f, 20.0f, // gyro mean x/y/z
    50.0f, 50.0f, 50.0f, // gyro rms x/y/z
    3.0f,                // accDyn ノルムpeak
    100.0f,              // gyro ノルムpeak
    45.0f,               // tilt
    1.0f, 1.0f, 1.0f     // grav x/y/z
};
#define MOTION_FRAME_MAGIC0      0xAA                // モデル受信フレームマジック
#define MOTION_FRAME_MAGIC1      0x55
#define MOTION_FRAME_STATUS_LAST 0xFF
#define MOTION_DISPLAY_MS        3000UL              // 検出結果の7セグ表示時間
struct MotionPattern {
    char name[MOTION_NAME_LEN];                      // パターン名（UTF-8）
    float centroid[MOTION_FEAT_DIM];                 // 正規化空間の重心
};
#define DISPLAY_UPDATE_INTERVAL_MS  1000
#define TEST_DISPLAY_MIN_INDEX 1
extern const int TEST_PATTERN_COUNT;
enum DisplayMode {
    DISPLAY_MODE_TIME,      // HH:MM
    DISPLAY_MODE_DATE,      // MMDD
    DISPLAY_MODE_WEEKDAY,   // MON/TUE/...
    DISPLAY_MODE_SECONDS,   // SS（モード4: 秒表示）
    DISPLAY_MODE_TEST,      // テスト（Phase 3 で使用）
    DISPLAY_MODE_COUNT
};
enum EpaperView {
    EP_VIEW_NONE = -1,        // 未描画（初回強制描画用の番兵）
    EP_VIEW_CLOCK,            // 標準（7seg = TIME）
    EP_VIEW_NOTIFICATION,     // 通知（7seg = DATE）
    EP_VIEW_DETAIL,           // 詳細（7seg = WEEKDAY）
    EP_VIEW_DETAIL_LARGE,     // 詳細大（モード4: 日付/経過/開始〜現在）
    EP_VIEW_UNSYNCED,         // 未同期
};
enum FuncMode {
    FUNC_MODE_1,    // モード1
    FUNC_MODE_2,    // モード2
    FUNC_MODE_3,    // モード3
    FUNC_MODE_4,    // モード4
    FUNC_MODE_COUNT
};
struct FuncModeBinding {
    FuncMode    funcMode;     // 統一モード名
    DisplayMode segDisplay;   // 7セグ表示内容
    EpaperView  epaperView;   // ePaper表示内容
};
static const FuncModeBinding FUNC_MODE_TABLE[FUNC_MODE_COUNT] = {
    { FUNC_MODE_1, DISPLAY_MODE_TIME,    EP_VIEW_CLOCK        },  // モード1: 時刻(HH:MM)  / 標準時計
    { FUNC_MODE_2, DISPLAY_MODE_DATE,    EP_VIEW_NOTIFICATION },  // モード2: 日付(MMDD)   / 通知
    { FUNC_MODE_3, DISPLAY_MODE_WEEKDAY, EP_VIEW_DETAIL       },  // モード3: 曜日(MON/TUE)/ 詳細
    { FUNC_MODE_4, DISPLAY_MODE_SECONDS, EP_VIEW_DETAIL_LARGE },  // モード4: 秒(SS)        / 詳細大(日付/経過/開始〜現在)
};
struct DateCache {
    int year;
    int month;
    int day;
    int weekday;
    uint32_t lastTimestamp;
    bool valid;
};
enum HidSwitchState {
    HID_STATE_IDLE,
    HID_STATE_PRESS,
    HID_STATE_REPEAT
};
enum MaintenanceMenu {
    MAINTENANCE_MENU_CANCEL,        // Cancel (normal boot / reboot)
    MAINTENANCE_MENU_TEST,          // Test mode
    MAINTENANCE_MENU_DFU,           // DFU mode (OTA)
    MAINTENANCE_MENU_FACTORY_RESET, // Factory reset
    MAINTENANCE_MENU_COUNT          // Number of menus
};
struct MaintenanceState {
    bool active;                           // Maintenance mode is active
    MaintenanceMenu currentMenu;           // Current menu selection
    unsigned long lastInteractionMillis;   // Last interaction time (for timeout)
    uint8_t selectedMenuIndex;            // Current menu index (0-based)
};
struct HidSwitch {
    uint8_t gpio;
    uint8_t pinState;
    unsigned long lastDebounceTime;
    unsigned long pressStartTime;
    HidSwitchState state;
    uint16_t keyCode;
};
extern TM1637Display* g_display;
extern volatile uint32_t g_currentTimestamp;   // JST換算のUnix timestamp
extern bool g_timeSynced;
extern DisplayMode g_displayMode;
extern unsigned long g_currentMillis;
extern unsigned long g_lastScreenMillis;
extern unsigned long g_lastCounterMillis;
extern DateCache g_dateCache;
extern unsigned long g_startupMillis;
extern char g_startupTimeStr[];   // 起動時刻(JST) "YYYY/MM/DD HH:MM"。初回時刻同期時に記録
extern int g_startupWeekday;      // 起動(初回同期)時の曜日 0=日..6=土。日をまたいでも開始日付に使用
#define EP_STARTUP_TIME_LEN 17    // "YYYY/MM/DD HH:MM" + null
#define NUM_HID_SWITCHES 7
extern HidSwitch hidSwitches[];
extern MaintenanceState g_maintenanceState;
extern bool g_showingCountdown;
extern uint16_t g_displayingKeyCode;
extern unsigned long g_keyCodeDisplayEndTime;
extern unsigned long g_lastModeChangeMillis;
#define MODE_AUTO_RETURN_TIMEOUT_MS 10000
extern int g_testDisplayIndex;
extern volatile uint32_t g_funcClicks;           // funcInputTask→loop: 未消費クリック数
extern volatile uint32_t g_lastFuncEdgeMs;       // 最終クリック時刻: ePaper描画合成用
extern volatile bool     g_funcLongPressPending; // funcInputTask→loop: 長押し(>=2秒)通知
#define NOTIFICATION_DISPLAY_TIMEOUT_MS 30000UL  // 通知表示時間（30秒）
#define NOTIFY_APP_LEN   33    // アプリ名上限 32B + null（ログ/将来用。描画には未使用）
#define NOTIFY_TEXT_LEN  201   // 通知本文上限 200B + null
struct NotifyFontSetting {
    int maxChars;          // この文字数以下の場合に適用
    const uint8_t* font;   // 使用するフォント（u8g2_font_...）
    int scale;             // 拡大倍率（1〜3）
};
static const NotifyFontSetting NOTIFY_FONT_SETTINGS[] = {
    { 10,  u8g2_font_b16_t_japanese3, 3 },  // 16pxフォント3倍 48px
    { 24,  u8g2_font_b12_t_japanese3, 3 },  // 12pxフォント3倍 36px
    { 26,  u8g2_font_b16_t_japanese3, 2 },  // 16pxフォント2倍 32px
    {999,  u8g2_font_b12_t_japanese3, 2 }   //
};
#define NUM_NOTIFY_FONT_SETTINGS (sizeof(NOTIFY_FONT_SETTINGS) / sizeof(NOTIFY_FONT_SETTINGS[0]))
extern volatile bool g_notificationActive;      // 通知表示中フラグ
extern unsigned long g_notificationEndTime;     // 通知表示の終了時刻（millis()）
extern char g_notificationApp[];                // アプリ名
extern char g_notificationText[];               // 通知本文
extern volatile bool g_epaperRedrawRequested;   // ePaper 強制再描画要求（ビュー変更検出用）
extern bool g_imuEnabled;        // BMI160 接続・有効フラグ（false で既存機能へフォールバック）
extern float g_imuAx, g_imuAy, g_imuAz;       // 加速度 [g]
extern float g_imuGx, g_imuGy, g_imuGz;       // 角速度 [deg/s]
extern unsigned long g_imuLastSampleMillis;   // 最終サンプリング時刻（millis()）
extern ImuSample g_imuRingBuffer[IMU_RING_BUFFER_SIZE];  // 6000B
extern volatile uint16_t g_imuRingHead;                  // 次書込位置（0..499）
extern volatile uint16_t g_imuRingCount;                 // 有効サンプル数（0..500）
extern bool g_imuDumpActive;             // 送信中フラグ
extern uint16_t g_imuDumpSeq;            // 次送信チャンク番号
extern uint16_t g_imuDumpTotal;          // 総チャンク数
extern uint16_t g_imuDumpSamplesToSend;  // 送信対象サンプル数（= 採取時点の count）
extern unsigned long g_imuDumpLastSend;  // 最終チャンク送信時刻（millis()）
extern uint8_t g_imuDumpRetry;           // 現チャンクのリトライ回数
extern bool g_imuRecordPending;            // IMU_RECORD_START: 4秒録音待機中
extern unsigned long g_imuRecordStartMillis; // 録音開始時刻
extern MotionPattern* g_motionPatterns;                     // ヒープ割当（.bss 配置重複回避）
extern uint8_t g_motionPatternCount;                         // パターン数
extern bool g_motionModelReady;                              // モデル受信済み
extern char g_detectedPattern[MOTION_NAME_LEN];              // 直近の検出パターン名（空=不明）
extern int g_motionDisplayIndex;                             // 7セグ表示中のパターン番号（-1=無効）
extern unsigned long g_motionDisplayEndTime;                 // 7セグ表示の終了時刻
#define PARKED_DISPLAY_TIMEOUT_MS 20000UL
extern bool g_parkedDisplayActive;                          // 駐車中: ePaperを詳細表示で維持（タイムアウトで解除）
extern unsigned long g_parkedDisplayStartMillis;            // 駐車詳細表示の開始時刻（millis()）
extern bool g_inferLogEnabled;                              // 推論ログBLE送信（INFER_LOG:1 でON・精度チューニング用）
extern bool g_motionModelSaveRequested;   // モデル保存要求（BLEコールバック→loopでFlash書き込み）
int getHours();
int getMinutes();
int getSeconds();
int getMonth();
int getDay();
int getWeekday();
int getYear();
void updateTimeDisplay();
void updateDateDisplay();
void updateWeekdayDisplay();
void updateSecondsDisplay();
void updateDisplayForCurrentMode();
void displayVersion();
void encodeStringToSegments(const char* str, uint8_t* data);
void updateTestDisplay();
void setupEpaper();
void updateEpaperDisplay();
void drawEpaperOtaState(const char* state, const char* ipStr = "");
void updateTimestamp();
void updateDisplayAndLedState();
void recordStartupTime();   // 初回時刻同期時に起動時刻(JST)を g_startupTimeStr へ記録
void updateMotionSave();                  // loop内でモデル保存(Flash書き込み)を実行（BLEコールバック外で安全に）
void motionTask(void* arg);              // updateMotionInference 実行タスク（16KB・logPrintミューテックスで安全）
void setupIMU();      // Wire.begin + BMI160 初期化（接続失敗時 g_imuEnabled=false でフォールバック）
void updateIMU();     // 50Hz(20ms) サンプリング + 生値読出し + リングバッファ push（loop から毎回呼出）
void dumpIMU();       // 生値シリアルダンプ（IMU_DEBUG_DUMP フラグで切替）
void handleImuDump();      // Phase 14-B: IMU_DUMP 要求受信（送信状態を初期化・即リターン）
void updateImuDump();      // Phase 14-B: loop内でチャンク分割送信を進行（30ms間隔・リトライ付き）
void handleImuRecordStart(); // 未来録り要求受信（10秒後に handleImuDump を起動）
void updateImuRecord();      // loop内で10秒経過を監視し handleImuDump へ
void loadMotionModel();                 // LittleFS からモデルをロード（起動時）
void handleMotionModelFrame(const uint8_t* data, size_t len);  // BLE onWrite からモデルフレーム受信
void updateMotionInference();           // loop から定周期で推論（結果を g_detectedPattern へ）
void processHidSwitches();
void processFunctionKey();
void sendHidKeyPress(uint16_t keyCode, const char* unused = NULL);
void sendHidKeyRelease(const char* unused = NULL);
void enterMaintenanceMode();
void exitMaintenanceMode();
void updateMaintenanceDisplay();
bool processMaintenanceMode();
void setupLog();
void logPrint(const char* tag, const char* format, ...);
enum LedState {
    LED_STATE_BOOT,              // 起動: 赤固定
    LED_STATE_NO_SYNC,           // 未接続+未同期: 赤点滅(1s)
    LED_STATE_SYNCED,            // 未接続+同期: 緑固定
    LED_STATE_CONNECTED_NO_SYNC, // 接続+未同期: 青点滅(1s)
    LED_STATE_CONNECTED_SYNCED,  // 接続+同期: 青固定
    LED_STATE_ERROR              // エラー: 赤早点滅(0.2s)
};
extern LedState g_currentLedState;
extern bool g_deviceConnected;   // Phase 5 (BLE) で設定
void setupLed();
void updateLed();
void setLedState(LedState state);
void setLedColor(bool red, bool green, bool blue);
void updateLedStateBasedOnStatus();
#define _BC_STR_INNER(s) #s
#define _BC_STR(s)       _BC_STR_INNER(s)
#ifdef UNIT_NAME
  #define BLE_DEVICE_NAME  "BikeClock-" _BC_STR(UNIT_NAME)
#else
  #define BLE_DEVICE_NAME  "BikeClock-ESP32"
#endif
#define BLE_SERVICE_UUID      "4fafc201-1fb5-459e-8fcc-c5c9c331914c"
#define BLE_CHAR_COMMAND_UUID "beb5483e-36e1-4688-b7f5-ea07361b26a0"
void setupBLE();
void deinitBLE();
void sendResponse(const char* message);
bool sendBinary(const uint8_t* data, size_t len);   // Phase 14-B: バイナリ notify（IMUチャンク送信）
void handleTimeSync(const char* command);
void handleGetVersion();
void handleKeyConfig(const char* command);
void handleNotify(const char* command);   // Phase 10: NOTIFY:app=...\n<本文>（fire-and-forget）
class NimBLEServer;
void setupHID(NimBLEServer* server);
#define KEYS_FILE_PATH "/keys.dat"
void setupFileSystem();
void loadSettings();
void saveSettings();
void resetKeySettingsToDefaults();
void resetToFactoryDefaults();
#define WIFI_FILE_PATH "/wifi.dat"
#define WIFI_SSID_MAX_LEN 32   // IEEE 802.11 SSID 上限
#define WIFI_PASS_MAX_LEN 63   // WPA パスフレーズ上限
bool loadWifiConfig(String& ssid, String& pass);          // 設定読込（成功=true・未設定/破損=false）
void saveWifiConfig(const char* ssid, const char* pass);  // 設定保存
bool hasWifiConfig();                                     // WiFi設定が保存済みか
void handleWifiConfig(const char* command);               // BLE SET:wifi: 受信処理
void startOtaDfuMode();
