pirorin215/btclock/cycleclock/cycleclock.ino

/**
 * CycleClock - XIAO BLE based bicycle ePaper clock
 *
 * 動作モデル(v0.4.15: BLE接続ありき・振動センサーは起動専用):
 * - 振動(開発中はタクトスイッチ)で System OFF からコールドスタート
 * - 起動から1分以内に BLE 接続が来なければ System OFF へ戻る(不在時の誤起動対策)
 * - BLEアドバタイズ → スマホアプリ(BTClockMob)が自動接続 → 時刻同期
 * - ePaper(WeAct 2.13")に時計を表示(分変化でフル更新)
 * - 接続中は寝ない(信号待ちでも継続)。切断後は1分で再接続されなければ System OFF
 * - 電源は18650をBATパッド直結(オンボード充電器でUSB充電可)
 *
 * 移植元:
 * - BLE・時刻処理: bikeclock/ (XIAO BLE版 v1.1.6)
 * - ePaper描画: bikeclock_esp32/ (v2.0.61, GxEPD2_213_B74)
 */

#include "cycleclock.h"

// --- Global Variables ---
volatile uint32_t g_currentTimestamp = 0;  // Unix timestamp (JST換算・アプリ側が+9h済みの値)
bool g_timeSynced = false;
bool g_deviceConnected = false;
unsigned long g_lastCounterMillis = 0;
unsigned long g_currentMillis = 0;
unsigned long g_startupMillis = 0;
unsigned long g_sleepTimerStartMs = 0;  // スリープ判定の基点(起床時刻で初期化・切断時に更新)
LedState g_currentLedState = LED_STATE_BOOT;
DateCache g_dateCache = {0, 0, 0, 0, 0, false};

// --- Notification (bikeclock_esp32 Phase 10 から移植) ---
volatile bool g_notificationActive = false;      // BLEコールバック(onWrite)が立てる
unsigned long g_notificationEndTime = 0;
char g_notificationApp[NOTIFY_APP_LEN] = {0};    // アプリ名(ログ用・本文空の時の代替表示)
char g_notificationText[NOTIFY_TEXT_LEN] = {0};  // 通知本文
volatile uint32_t g_notificationSeq = 0;         // 受信連番(手動通知モードの再描画判定)

// --- Display Mode (FUNCキー機構・bikeclock から移植) ---
DisplayMode g_displayMode = DISPLAY_MODE_TIME;
unsigned long g_lastModeChangeMillis = 0;

// --- Time Helper Functions (bikeclock.ino から移植) ---
int getHours() {
    return (g_currentTimestamp % 86400) / 3600;
}

int getMinutes() {
    return (g_currentTimestamp % 3600) / 60;
}

int getSeconds() {
    return g_currentTimestamp % 60;
}

// 閏年判定(グレゴリオ暦)
static bool isLeapYear(uint32_t year) {
    return year % 4 == 0 && (year % 100 != 0 || year % 400 == 0);
}

// 日付換算(年/月日/曜日)。同一秒内の getMonth/getDay/getWeekday/getYear の
// 再計算を g_dateCache に1回にまとめる(呼び出し側はキャッシュを意識しない)。
static const DateCache& dateCache() {
    if (g_dateCache.valid && g_dateCache.lastTimestamp == g_currentTimestamp) {
        return g_dateCache;
    }

    uint32_t daysSinceEpoch = g_currentTimestamp / 86400;
    uint32_t days = daysSinceEpoch;
    uint32_t year = 1970;
    uint32_t daysInYear;

    while ((daysInYear = isLeapYear(year) ? 366 : 365) <= days) {
        days -= daysInYear;
        year++;
    }

    static const uint8_t days_in_month[] = {31, 28, 31, 30, 31, 30, 31, 31, 30, 31, 30, 31};
    const uint8_t dimFeb = (daysInYear == 366) ? 29 : 28;

    int m = 0;
    for (m = 0; m < 12; m++) {
        uint8_t dim = (m == 1) ? dimFeb : days_in_month[m];
        if (days < dim) break;
        days -= dim;
    }

    g_dateCache.month = m + 1;
    g_dateCache.day = days + 1;
    g_dateCache.weekday = (daysSinceEpoch + 4) % 7;   // 1970-01-01は木曜(0=日曜で+4)
    g_dateCache.year = year;
    g_dateCache.lastTimestamp = g_currentTimestamp;
    g_dateCache.valid = true;
    return g_dateCache;
}

int getMonth() {
    return dateCache().month;
}

int getDay() {
    return dateCache().day;
}

int getWeekday() {
    return dateCache().weekday;
}

int getYear() {
    return dateCache().year;
}

// --- System Utilities ---
// 経過秒を一括加算し、ミリ秒端数は次回へ繰り越す。ePaperのフル更新や
// BLE処理でloopが詰まっても時計の遅れが蓄積しない(旧実装は1呼び出し最大+1秒で、
// 更新のたびに数秒ずつ遅れ、end=current式で端数も毎秒捨てていた)。
void updateTimestamp() {
    unsigned long elapsed = g_currentMillis - g_lastCounterMillis;
    if (elapsed >= 1000) {
        unsigned long sec = elapsed / 1000;
        g_currentTimestamp += (uint32_t)sec;
        g_lastCounterMillis += sec * 1000;   // 端数を繰り越す
    }
}

// --- Logging ---
void setupLog() {
    g_startupMillis = millis();
}

void logPrint(const char* tag, const char* format, ...) {
    unsigned long elapsed = millis() - g_startupMillis;

    Serial.printf("[%4lu.%03lu] ", elapsed / 1000, elapsed % 1000);

    if (tag != nullptr && tag[0] != '\0') {
        Serial.printf("[%s] ", tag);
    }

    char buffer[256];
    va_list args;
    va_start(args, format);
    vsnprintf(buffer, sizeof(buffer), format, args);
    va_end(args);

    Serial.println(buffer);
}

// --- FUNCキー処理(v0.3.9・専用GPIO=D2) ---
// 50ms安定ではじめて変化を確定させ、解放エッジ(クリック確定)で動作を決める。
// 押下開始エッジでは何もしない。(v0.4.15からD0のソフト検出は廃止。
// 振動センサーはSystem OFF復帰のDETECT専用)
// D0(振動)と分離済みのため走行中の振動で誤発動しない。長押しは未使用
// (bikeclockのメンテナンスメニューモードへの拡張余地)。
// v0.4.1: D2もSystem OFFからのウェイクピンのため、FUNC押下で起床した直後の
// releaseはモード切替としない(起こすための押下と切替操作を分離する)。
// v0.4.20: 通知ビュー(モード2・時計への新着自動上書き)表示中はクリックを
// ページ送りに割当てる。複数ページの間は次ページを送り、最終ページに達したら
// 通常動作へ合流する:
//   - モード2(手動)          → そのままモード順送り(→モード3)
//   - 時計への自動上書き表示 → 通知を閉じて時計へ戻す(読了の合図)
// 1ページに収まる通知はページ送りが働かず、従来どおりのモード順送りになる。
static bool s_fkStable = HIGH;               // デバウス確定後の安定値(プルアップ・HIGH=未押下)
static bool s_fkLastReading = HIGH;          // 前回の生読み取り値
static unsigned long s_fkLastChangeMs = 0;   // 最後に読み取りが変化した時刻
static bool s_fkIgnoreFirstRelease = false;  // FUNC押下で起床した場合の初回release無視

void processFuncKey() {
    bool reading = digitalRead(FUNC_SW_GPIO);
    if (reading != s_fkLastReading) {
        s_fkLastChangeMs = g_currentMillis;
        s_fkLastReading = reading;
    }
    if (g_currentMillis - s_fkLastChangeMs < 50 || reading == s_fkStable) return;
    s_fkStable = reading;
    if (s_fkStable != HIGH) return;   // 押下開始では何もしない(解放でクリック確定)

    if (s_fkIgnoreFirstRelease) {
        // FUNCキー押下でSystem OFFから起床した場合の「離した」。
        // 起床操作自体はモード切替としない
        s_fkIgnoreFirstRelease = false;
        logPrint("FUNC", "Wake release ignored");
        return;
    }

    // 通知ビュー表示中はクリック=ページ送り(v0.4.20)
    const bool notifyView =
        g_displayMode == DISPLAY_MODE_NOTIFICATION ||
        (g_displayMode == DISPLAY_MODE_TIME && g_notificationActive);
    if (notifyView) {
        switch (notifyPageAdvance()) {
            case NOTIFY_PAGE_ADVANCED:
                return;   // 次ページの描画・タイマー延長はnotifyPageAdvance内で完了
            case NOTIFY_PAGE_LAST:
                if (g_displayMode == DISPLAY_MODE_TIME) {
                    notifyDismiss();   // 読了: 自動上書きを閉じて時計へ
                    return;
                }
                break;   // モード2: 下のモード順送りへ
            case NOTIFY_PAGE_SINGLE:
                break;   // 1ページ通知: 従来どおりモード順送りへ
        }
    }

    // 離した(クリック確定)でモードを順送り
    g_displayMode = (DisplayMode)((g_displayMode + 1) % DISPLAY_MODE_COUNT);
    g_lastModeChangeMillis = g_currentMillis;
    logPrint("FUNC", "Mode changed to %d", (int)g_displayMode);
}

// --- スリープ判定(v0.4.15: BLE接続有無のみ) ---
// BLE に接続していない状態が SLEEP_IDLE_TIMEOUT_MS(1分)続けば System OFF。
// 基点 g_sleepTimerStartMs は起床時刻(setup)と切断時刻(onDisconnect)で更新する:
//   - 起動: 1分以内に接続が来なければ寝る(不在時の誤起動=誤起動回数+1)
//   - 切断: 再接続されなければ1分で寝る(瞬断は1分以内の再接続で継続)
// 接続中は判定自体を停止する(v0.4.9・信号待ちでも寝ない)。
void checkSleepTimeout() {
    if (g_deviceConnected) return;
    if (g_currentMillis - g_sleepTimerStartMs < SLEEP_IDLE_TIMEOUT_MS) return;

    logPrint("SLEEP", "No BLE connection for %lu min - entering System OFF",
             (unsigned long)(SLEEP_IDLE_TIMEOUT_MS / 60000));
    enterSystemOff();  // 戻らない
}

// --- Main Functions ---
void setup() {
    Serial.begin(115200);
    setupLog();
    setupStats();   // v0.4.11: 誤起動回数をフラッシュから復元

    logPrint("CYCLECLOCK", __DATE__ " " __TIME__);

    // 起動要因の判別(SoftDevice起動前=直接レジスタ読み・write-1-to-clear)
    // System OFF からの起床なら RESETREAS.OFF が立っている
    {
        uint32_t reason = NRF_POWER->RESETREAS;
        NRF_POWER->RESETREAS = 0xFFFFFFFF;
        if (reason & POWER_RESETREAS_OFF_Msk) {
            logPrint("POWER", "Wakeup from System OFF (wake switch)");
        } else if (reason & POWER_RESETREAS_RESETPIN_Msk) {
            logPrint("POWER", "Reset from RESET pin");
        }
    }

    // 電源安定待ち(電池コールドスタート直後のePaper初期化失敗回避)
    delay(500);

    // ウェイクスイッチ(内部プルアップ・導通=LOW)とFUNCキー(同結線)。
    // D0はSystem OFF復帰(DETECT)と寝る直前の導通解放待ちにのみ使う
    // (v0.4.15から起動後のソフト検出は廃止)
    pinMode(WAKE_SW_GPIO, INPUT_PULLUP);
    pinMode(FUNC_SW_GPIO, INPUT_PULLUP);

    // FUNCキー押下での起床(v0.4.1): RESETREASではD0/D2の判別ができないため
    // 起動直後のピン読みで推定する。押したまま起床しているので初回releaseを
    // モード切替にしない(processFuncKey の s_fkIgnoreFirstRelease)
    if (digitalRead(FUNC_SW_GPIO) == LOW) {
        s_fkIgnoreFirstRelease = true;
        logPrint("POWER", "Wakeup via FUNC key");
    }

    // 電池電圧を即測定(アプリの初回GET:batteryに間に合わせる)
    g_currentMillis = millis();
    updateBattery();

    setupLed();

    // WS2812B(v0.4.16): ePaper電源上電の前にDINをLOWへ確定
    setupLedStrip();

    // ePaper初期化+スプラッシュ表示(EN=HIGHでVOUT上電=WS2812Bにも通電)
    setupEpaper();

    // 起動演出(VOUT上電後なのでLEDが受信できる・配線確認用の白点滅)
    ledStripFlash(STRIP_BOOT_R, STRIP_BOOT_G, STRIP_BOOT_B, STRIP_BOOT_FLASH);

    // BLE初期化+アドバタイズ開始
    setupBLE();

    g_lastCounterMillis = millis();
    g_sleepTimerStartMs = millis();   // 起動時刻をスリープ判定の基点に(1分以内に接続が来なければ寝る)

    logPrint("INIT", "Ready - waiting for BLE connection...");
}

void loop() {
    g_currentMillis = millis();

    processFuncKey();
    updateLed();
    updateLedStrip();
    handleLedStripSerial();
    updateTimestamp();
    updateBattery();
    updateEpaperDisplay();
    checkSleepTimeout();

    delay(10);
}
