pirorin215/btclock/bikeclock/bikeclock_keys.ino

/**
 * BikeClock - HID Switch & Function Key Processing
 *
 * This file handles:
 * - MCP23S17 I/O Expander initialization
 * - HID switch processing (SW1-SW7)
 * - Function key processing (SW8)
 */

// --- External Declarations ---
extern TM1637Display* g_display;
extern Adafruit_MCP23X17 mcp;
extern bool g_mcp23S17Connected;
extern bool g_showingCountdown;
extern DisplayMode g_displayMode;
extern int g_testDisplayIndex;

// HID switch array (defined in bikeclock.ino)
extern HidSwitch hidSwitches[];

// --- MCP23S17 Initialization ---
// Initialize MCP23S17 I/O expander (SPI)
void setupMCP23S17() {
    logPrint("MCP", "Starting MCP23S17 initialization (Hardware SPI, Low Speed)...");
    logPrint("MCP", "SPI Frequency: %d Hz (%d kHz)", MCP_SPI_FREQ, MCP_SPI_FREQ / 1000);

    // Start hardware SPI
    SPI.begin();

    // Initialize MCP23S17 with default frequency (library uses 1MHz internally)
    // Note: To use custom frequency, we need to modify the library approach
    if (!mcp.begin_SPI(MCP_SPI_CS_GPIO, &SPI)) {
        logPrint("MCP", "ERROR: MCP23S17 NOT detected!");
        g_mcp23S17Connected = false;
        return;
    }
    logPrint("MCP", "MCP23S17 initialized successfully");

    // Configure all pins as inputs with pull-up
    for (int i = 0; i < 8; i++) {
        mcp.pinMode(i, INPUT_PULLUP);
    }
    delay(200); // Give plenty of time for pull-ups to rise

    // Communication Verification: Must not be 0x00 if nothing is pressed
    logPrint("MCP", "Verifying connection...");
    uint8_t pinValues = 0;
    int retry = 0;
    while (retry < 10) {
        pinValues = 0;
        for (int i = 0; i < 8; i++) {
            if (mcp.digitalRead(i)) pinValues |= (1 << i);
        }

        if (pinValues != 0x00) break; // Found something!

        logPrint("MCP", "Still reading 0x00, retrying...");
        delay(100);
        retry++;
    }

    if (pinValues == 0x00) {
        logPrint("MCP", "FATAL ERROR: All pins read as LOW. Communication is dead.");
        g_mcp23S17Connected = false;
        return;
    }

    logPrint("MCP", "Connection verified! Initial state: 0x%02X", pinValues);

    // Synchronize initial hardware state simply
    for (int i = 0; i < NUM_HID_SWITCHES; i++) {
        hidSwitches[i].pinState = (pinValues >> hidSwitches[i].gpio) & 0x01;
        hidSwitches[i].state = HID_STATE_IDLE;
        hidSwitches[i].lastDebounceTime = millis();
    }

    g_mcp23S17Connected = true;
    logPrint("MCP", "MCP23S17 initialized successfully");
}

// --- HID Switch Processing ---
void processHidSwitches() {
    // Only process HID switches if MCP23S17 is connected
    if (!g_mcp23S17Connected) {
        return;
    }

    // Check if in maintenance mode - skip HID processing
    extern MaintenanceState g_maintenanceState;
    if (g_maintenanceState.active) {
        return;  // Skip normal HID processing in maintenance mode
    }

    // Additional safety check: verify all pins are not stuck at LOW
    // This can happen if MCP23S17 is disconnected but SPI bus is alive
    uint8_t allPins = 0;
    for (int i = 0; i < 8; i++) {
        if (mcp.digitalRead(i)) allPins |= (1 << i);
    }
    if (allPins == 0x00) {
        // All pins reading LOW - likely disconnected
        // Disable further HID processing
        logPrint("HID", "WARNING: All pins LOW - disabling HID processing");
        g_mcp23S17Connected = false;
        return;
    }

    for (int i = 0; i < NUM_HID_SWITCHES; i++) {
        // Read from MCP23S17
        uint8_t reading = mcp.digitalRead(hidSwitches[i].gpio);

        // Only apply debounce when switch is released (LOW->HIGH transition)
        if (reading == HIGH && hidSwitches[i].pinState == LOW) {
            // Switch released - update debounce time
            hidSwitches[i].lastDebounceTime = millis();
        }
        // Always update pinState for next comparison
        hidSwitches[i].pinState = reading;

        // Skip debounce check during press to ensure quick response
        bool skipDebounce = (hidSwitches[i].state == HID_STATE_PRESS);

        if (skipDebounce || (millis() - hidSwitches[i].lastDebounceTime) > HID_DEBOUNCE_DELAY_MS) {
            // State machine
            switch (hidSwitches[i].state) {
                case HID_STATE_IDLE:
                    // Check if switch is pressed (LOW)
                    if (reading == LOW) {
                        logPrint("HID", "SW%d P", i + 1);
                        sendHidKeyPress(hidSwitches[i].keyCode, NULL);

                        // Display key code on 7-segment
                        extern uint16_t g_displayingKeyCode;
                        extern unsigned long g_keyCodeDisplayEndTime;
                        g_displayingKeyCode = hidSwitches[i].keyCode;
                        g_keyCodeDisplayEndTime = millis() + 500;  // Display for 500ms
                        g_display->showNumberDec(hidSwitches[i].keyCode);
                        logPrint("HID", "Displaying key code: %d", hidSwitches[i].keyCode);

                        hidSwitches[i].state = HID_STATE_PRESS;
                    }
                    break;

                case HID_STATE_PRESS:
                    if (reading == HIGH) {
                        // Switch released
                        logPrint("HID", "SW%d R", i + 1);
                        sendHidKeyRelease(NULL);
                        hidSwitches[i].state = HID_STATE_IDLE;
                    }
                    break;
            }
        }
    }
}

// --- Common Countdown Function ---
// Perform countdown display with LED feedback
// startSeconds: countdown start value (e.g., 5 for "5,4,3,2,1")
// totalSeconds: total duration to wait (must be >= startSeconds)
// Returns: true if completed, false if key released early
bool performCountdown(int startSeconds, int totalSeconds) {
    unsigned long pressStartTime = millis();

    while (mcp.digitalRead(MCP_FUNC_PIN) == LOW && (millis() - pressStartTime < (totalSeconds * 1000UL))) {
        unsigned long elapsed = millis() - pressStartTime;
        int secondsLeft = startSeconds - (int)(elapsed / 1000);

        if (secondsLeft > 0) {
            // Update 7-segment display with countdown
            g_display->showNumberDec(secondsLeft);

            // LED feedback: flash yellow/orange based on urgency
            bool ledOn = ((elapsed / 200) % 2) == 0;
            if (secondsLeft <= 2) {
                // Last 2 seconds: faster red flash
                setLedColor(ledOn, false, false);
            } else if (secondsLeft == 3) {
                // 3 seconds: yellow flash
                setLedColor(ledOn, ledOn, false);
            } else {
                // 4+ seconds: green/orange flash
                setLedColor(ledOn, ledOn ? false : true, false);
            }
        }
        delay(50);
    }

    // Check if key was released early
    if (mcp.digitalRead(MCP_FUNC_PIN) == HIGH) {
        return false; // Aborted
    }

    return true; // Completed
}

// --- Function Key Processing (Mode Switch) ---
void processFunctionKey() {
    // Only process FUNC key if MCP23S17 is connected
    if (!g_mcp23S17Connected) {
        return;
    }

    static unsigned long lastDebounce = 0;
    static bool lastState = HIGH;
    static bool debouncedState = HIGH;
    static bool inLongPressSequence = false;
    static unsigned long pressStartTime = 0;

    // Read from MCP23S17 GP7
    bool reading = mcp.digitalRead(MCP_FUNC_PIN);

    // Detect state change
    if (reading != lastState) {
        lastDebounce = millis();
        lastState = reading;
    }

    // After debounce delay
    if ((millis() - lastDebounce) > HID_DEBOUNCE_DELAY_MS && reading != debouncedState) {
        debouncedState = reading;

        // Only process on press (LOW)
        if (debouncedState == LOW) {
            // Key pressed - start timing
            pressStartTime = millis();
            inLongPressSequence = false;
            logPrint("FUNC", "SW8 pressed");
        } else {
            // Key released
            if (!inLongPressSequence) {
                // Short press - mode change OR maintenance menu navigation
                extern MaintenanceState g_maintenanceState;

                if (g_maintenanceState.active) {
                    // Maintenance mode: cycle through menus
                    logPrint("FUNC", "Maintenance mode - cycling menu");
                    g_maintenanceState.selectedMenuIndex++;
                    if (g_maintenanceState.selectedMenuIndex >= MAINTENANCE_MENU_COUNT) {
                        g_maintenanceState.selectedMenuIndex = 0;
                    }
                    g_maintenanceState.currentMenu = static_cast<MaintenanceMenu>(g_maintenanceState.selectedMenuIndex);
                    g_maintenanceState.lastInteractionMillis = millis();
                    updateMaintenanceDisplay();
                } else {
                    // Normal mode: mode change
                    logPrint("FUNC", "Short press - Mode change triggered");
                    if (g_displayMode == DISPLAY_MODE_TEST) {
                        // Test mode: cycle through test displays
                        g_testDisplayIndex++;
                        if (g_testDisplayIndex > TEST_PATTERN_COUNT) {
                            g_testDisplayIndex = TEST_DISPLAY_MIN_INDEX;
                        }
                        extern void updateTestDisplay();
                        updateTestDisplay();
                        logPrint("TEST", "Display %d", g_testDisplayIndex);
                    } else {
                        // Normal mode: switch display mode (cycle through TIME, DATE, WEEKDAY)
                        if (g_displayMode >= DISPLAY_MODE_WEEKDAY) {
                            g_displayMode = DISPLAY_MODE_TIME;
                        } else {
                            g_displayMode = (DisplayMode)(g_displayMode + 1);
                        }

                        // Record mode change time for auto-return timeout
                        extern unsigned long g_lastModeChangeMillis;
                        g_lastModeChangeMillis = millis();

                        // Update display immediately
                        extern void updateDisplayForCurrentMode();
                        updateDisplayForCurrentMode();

                        logPrint("FUNC", "Mode changed to: %d", g_displayMode);
                    }
                }
            } else if (inLongPressSequence) {
                // User released during countdown - restore display
                extern void updateDisplayForCurrentMode();
                updateDisplayForCurrentMode();
            }
            inLongPressSequence = false;
            g_showingCountdown = false;
        }
    }

    // Check for long press while key is held
    if (debouncedState == LOW && !inLongPressSequence) {
        unsigned long pressDuration = millis() - pressStartTime;

        // Start countdown sequence after 2 seconds
        if (pressDuration >= 2000) {
            inLongPressSequence = true;
            g_showingCountdown = true;
            logPrint("FUNC", "Long press detected - starting countdown");

            // Perform countdown: 3,2,1 (3 seconds)
            bool completed = performCountdown(3, 3);

            if (completed) {
                // Enter maintenance mode instead of reboot
                logPrint("FUNC", "Maintenance mode triggered");
                g_display->showNumberDec(0000);  // Show "0000"
                setLedColor(true, false, false);  // Red
                delay(500);

                // Enter maintenance mode
                enterMaintenanceMode();
            } else {
                // User released during countdown
                inLongPressSequence = false;
                g_showingCountdown = false;
            }
        }
    }
}
