pirorin215/btclock/(commit log)

2026-04-23 fastrecプロジェクトからbikeclockファームウェアを分離して移行
2026-04-24 BLE時刻同期機能を実装
2026-04-24 文字起こし・録音機能削除,Google Tasks連携機能削除
2026-04-24 APIキー,不要パネル削除、録音、音声認識削除,依存ライブラリ整理
2026-04-24 住所表示実装,定期的な履歴記録の初期化タイミング修正,切断中の履歴データ増加の廃止
2026-04-24 HIDキー入力機能追加。キーコード変更機能。
2026-04-25 キーイベント処理の残骸削除。不要な設定管理機能の削除。デバイス設定機能の残骸削除。ログ簡素化
2026-04-25 内蔵RGB LEDで状態表示。7セグの表示モード追加。テストモード追加。
2026-05-02 時刻同期のJST対応を統一して日付・曜日のバグを修正
2026-05-02 IOエキスパンダーでスイッチ拡張しアプリ側をSW1-SW7に対応
    - MCP23S17でスイッチを8つ（SW1-SW7 + FUNC）に拡張
    - デフォルトキーコード設定をドキュメントに統合
    - AndroidアプリをSW1-SW7に対応させ、Arduino側のデフォルト設定に統合
2026-05-02 長押しリピート改善とファクトリーリセット機能の実装
    - HIDスイッチの長押しリピート処理を修正（デバウンス処理の改善）
    - キー初期設定を変更（SW1:右、SW2:下、SW3:上、SW4:左）
    - ファクトリーリセット機能を実装
    * 起動時にFUNCキー5秒長押しで実行
    * InternalFS全体をフォーマットして完全消去
    * LEDと7セグメントで視覚的フィードバック
    * 自動再起動して出荷時状態に戻す
    - 起動時のコンソール待ちを削除（即座起動）
    - 関数化でコードを整理（resetToFactoryDefaults, checkStartupFuncKey等）
    - 初期化中はBLE接続を受け付け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
    [bikeclock.h, bikeclock.ino, bikeclock_ble.ino, bikeclock_keys.ino]
2026-05-02 IOエキスパンダー未接続時の暴走対策とカウントダウン処理の共通化
2026-05-20 BLE自動接続の安定化
2026-05-26 ルート地図を追加
2026-05-28 BLEスキャンの省電力最適化
    - CALLBACK_TYPE_FIRST_MATCHに変更（CPUウェイクアップ削減）
    - reportDelayを1000msに設定（バッチ処理で電池消費削減）
    - 期待効果：電池消費30-40%削減、検知遅延最大1秒
2026-06-15 ESP32-S3版を新規作成: グループ1（表示・LED・BLE時刻同期）
2026-06-15 ePaper表示を追加: 昼間視認性向上（TM1637 7セグと併用）
    WeAct 2.13" ePaper(BW, GxEPD2_213_B74) + U8g2日本語フォント。
    時刻(大)+曜日+日付を表示。専用SPI3_HOST(CS=1/DC=2/RST=3/BUSY=10/SCK=12/MOSI=11)。
    分変化は時刻帯の部分更新、日替わり・初回同期・15分ごとに全画面フル更新でゴースト対策。
    ファームウェア 2.0.4 → 2.0.5。
2026-06-15 ePaper表示レイアウト改善: 時刻62px、下段32px統一、乗車時間と曜日漢字を追加
    - 時刻フォントを78px→62pxに調整
    - 下段(日付/経過時間)を24px→32pxに拡大
    - 曜日漢字をGNU Unifont 16x16ビットマップから32px描画で実装
    (U8g2の大きいフォントは漢字非対応のため自前ビットマップ化)
    - 電源ONからの乗車時間(HH:MM)表示を新規追加
    - READMEにESP32-S3 SuperMini参考URLを追記
2026-06-15 ePaperレイアウト調整: 区切り線2段レイアウト、左欄縦表示、時計アイコン、太字、起動時コントラスト安定
    - 時刻を右寄せ、縦線/横線で左欄・時刻・経過時間を区切る2段レイアウト
    - 左欄に曜日漢字(太字・上下左右膨張)と日付(日付き)を縦表示
    - 経過時間の左に時計アイコン(2重円+太い針)を追加
    - 起動直後の部分更新の薄さ対策: 同期後2回はフル更新(ウォームアップ)
    - 曜日漢字フォント32→48px、日付32→38px、左端寄せ等の微調整
2026-06-16 ePaperの表示を毎分のフル更新に統一し、部分更新に関連するロジックや記述を完全に削除
2026-06-16 起動時バージョン表示のフォント調整。起動ループ回避
2026-06-16 Phase 3（物理スイッチ直接接続）実装とピン割り当て変更
    - ピン割り当て変更: SW3-SW7/FUNC を (8,9,13,14,21,47) → (13,14,35,38,39,8)
    - VBUS_SENSE(Phase 3.5)を削除
    - HIDスイッチ検出・メンテナンスモード・テスト表示を実装（bikeclock_esp32_keys.ino 新規）
    - README/TODO/keys.ino のピン定義記述をコード(bikeclock.h)と整合させる
    - ファームウェアバージョン 2.0.16 → 2.0.17
2026-06-16 ESP32版: Phase4 LittleFS設定永続化とデバイス名変更、アプリ接続先BTの選択機能追加
2026-06-17 Phase6 BLE HID実装完了。ドキュメント整合性修正
2026-06-17 Phase 9 ePaper 3モード連動表示を実装
    FUNCボタンの7セグ表示モード（TIME/DATE/WEEKDAY）に連動してePaperの表示を
    標準/通知/詳細の3種類に切り替える機能を追加。
    - updateEpaperDisplayをEpaperViewによるディスパッチに変更
    - 詳細表示: 開始時刻・経過時間・現在日時・HIDキー設定（切替時スナップショット1回描画）
    - 通知表示スタブ（通知なし）、起動時刻(JST)記録（recordStartupTime）
    - getYear追加、HIDキーコード→人間可読名マッピング
    - TODO.mdにPhase 9〜11の計画を追記
    - FIRMWARE_VERSION_PATCH 21→22
2026-06-17 Phase 10 BLE経由でスマホ通知を受信しePaperに表示する機能を実装
    - NOTIFY:app=<名>\n<本文> プロトコルの受信ハンドラ（fire-and-forget）
    - 受信時にePaperを通知表示へ自動切替、30秒後に時計へ自動復帰
    - epaper_testのdrawWrappedTextを移植（本文のみ折返し表示）
    - MTU 247拡大、200B切り詰め（UTF-8境界巻き戻し）
2026-06-17 Phase 11 NotificationListenerServiceでスマホ通知をBikeClockへ転送
    - BikeNotificationListener新規作成（MessagingStyle抽出・常駐通知除外・3秒デバウンス）
    - BleRepositoryに送信シリアライズ(sendCommandSerial)を追加
    - アプリ設定に通知転送ON/OFFと通知アクセス許可誘導UIを追加
    - TODO.mdをプロジェクトルートへ移行、進捗反映
2026-06-17 Phase 12 ePaper通知表示を文字数に応じたフォント段階切替に対応
    - NOTIFY_FONT_SETTINGS配列で文字数→フォント/倍率の段階を定義（bikeclock.h）、ファームウェアv2.0.24
    - ScaledGFXラッパーで小フォントをピクセル拡大描画し、utf8CharCount()で文字数をカウント（epaper）
    - UTF-8境界巻き戻しを切り詰め発生時のみ実行するよう最適化（ble）
2026-06-17 Phase 13 通知の最大表示文字数設定と送信デバッグ画面を追加
2026-06-19 Phase 14 BMI160 IMUモジュールを追加・初期化不具合を修正
    - GY-BMI160(I2C)のIMUモジュールを新設しsetup/loopへ組込み（未接続時はフォールバック）
    - SW1/SW2をGPIO41/47へ移動し、空いたGPIO4/5をI2C(SDA/SCL)へ再割当て
    - BMI160初期化バグ修正（加速度・ジャイロとも正常サンプリング、ERR=0x00）:
    * PMU_STATUS判定を正規レイアウトへ是正（ACC=bits[5:4], GYR=bits[3:2]）
    * GYR_CONFのODR予約値(0x22)を50Hz(0x27)へ修正しジャイロ凍結を解消
    * ACC_RANGE(0x03)/ACC_CONF(0x27)を正しい値へ是正
    * 誤マスクによるCMDリトライ連打(ERR=0x02)を解消し加速度データ出力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
    [bikeclock.h, bikeclock_esp32.ino, bikeclock_esp32_imu.ino]
2026-06-19 Phase 14-B スマホ経由でIMUデータを採取する機能を追加
    [マイコン] BMI160のリングバッファ（直近10秒・500サンプル×6軸）を常時蓄積し、
    IMU_DUMPコマンドでバイナリチャンク分割notify送信。updateIMUをメンテナンス
    ブロック外へ移動し常時サンプリング化（駐車検知14-Cでも必須）。
    [Android] チャンク受信・再構築・ラベル/メモ付きCSVシェアを行うIMU採取画面
    （ImuDataCaptureScreen / ImuDataCaptureViewModel）を新規追加。
    onCharacteristicChangedで0xAA55マジック判定により、既存の文字列受信パス
    （0x00切り詰め）を維持しつつバイナリチャン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
2026-06-20 ESP32-S3版の複数台運用対応とハードウェア設定を修正
    - UNIT_NAMEビルドフラグでBLEデバイス名を個別指定可能に（bikeclock.h, compile.sh）
    - BMI160 IMUのSDA/SCLピン割当てを修正（SCL=4, SDA=5）
    - ePaperの表示向きを setRotation(3) に変更
    - READMEのGPIO一覧を表面/背面ピンに分割して整理
    - ファームウェアバージョン 2.0.31 → 2.0.32
    [bikeclock.h, bikeclock_esp32_epaper.ino]
2026-06-21 IMUデータ採取を取得完了時にダウンロードへ自動保存、接続状態判定をConnectedのみに修正
    - 取得完了時にMediaStore.Downloadsへ自動保存（API<29は外部ストレージにフォールバック）
    - シェアボタン押下時のみ保存される仕様を廃止し、押し忘れによるデータ消失を防止
    - CSVをシェアボタンは保存済みファイルを共有する形に変更
    - IMU採取画面の接続判定をConnectedのみに統一（Pairedで接続中表示・取得ボタンが有効になる不具合を修正）
2026-06-21 TM1637とWS2812の輝度を下げる
2026-06-21 モーションパターン学習機能(Phase 1)を追加
    採取したIMUデータから特徴量を抽出し、ラベル別に重心を学習してマイコンへ送信する機能。
    - 特徴量抽出(9次元): MotionFeatures、Android/マイコン共通定義(1次IIR)
    - 学習: MotionModel、重心法＋z-score正規化
    - 永続化: MotionTrainingRepository (DataStore)
    - 学習画面: MotionLearningScreen、サンプル一覧・学習・マイコン送信
    - 採取画面に「学習データに追加」を連携
    - BleRepositoryにモデル送信(0xAA55セグメントフレーム)
    - ImuSampleをdata層へ切り出し
2026-06-21 モーションパターン認識(Phase 2)とIMU未来録りを採取に対応
    - モーション認識エンジン(bikeclock_esp32_motion.ino): 学習モデル受信・LittleFS保存・特徴量抽出・最近傍推論
    - BLE onWrite で 0xAA55 モデルフレームを受信・再構築
    - IMU_RECORD_START(未来録り): 10秒録音後にリングバッファ送信
    - 特徴量定義を Android(MotionFeatures.kt)と完全一致
    - ファームウェア 2.0.35
2026-06-21 IMU採取を未来録りに変更し学習データへの自動追加に対応
    - データ取得開始→10秒録音(進捗ゲージ)→チャンク受信→完了のフロー
    - 取得完了時に学習データへ自動追加(学習データに追加ボタン廃止)
    - 送信コマンドを IMU_RECORD_START へ
    - クリアして再取得ボタン廃止(完了後にデータ取得開始で連続採取可能)
    - モーション学習画面に学習データとモデルの全削除を追加
2026-06-21 モーション検出結果を7セグに3秒表示
    - 検出時に "MTnn"（パターン番号2桁）を7セグLEDに3秒間表示、時刻と区別
    - パターン番号は固定マップ（駐車=0,解除=1,走行=2,カーブ=3,停車=4,アイドリング=5）
    - Android IMU_LABELS と同順のラベルテーブルで検出名→番号を検索
    - 検出確定時に表示要求をセット、3秒後に自動で時刻へ復帰
    - ファームウェア 2.0.36
2026-06-21 駐車検知でePaperを詳細表示にし、開発用固定時刻・IMUダンプを無効化
    - 駐車検知でePaperを詳細表示へ（g_parkedDisplayActive）。走行検知で時計に復帰、時間経過では戻さない
    - 詳細の「開始」時刻を実際の時刻にするため TEST_FIXED_TIME(開発用固定時刻06-15)を無効化
    - IMU_DEBUG_DUMP(10Hz生値ダンプ)を無効化しログを見やすく
    - ファームウェア 2.0.39
2026-06-21 README/TODOにモーション学習・駐車検知の進捗を反映
    - TODO: Phase 14-C を機械学習ベース（完了）に更新。Phase 15（モーションパターン学習・検出パイプライン）を追加
    - README: 主な機能に駐車検知（ePaper詳細表示）・IMU採取（未来録り）・モーション学習を追加
2026-06-21 FUNCキー押下で駐車表示を解除できるように修正
    - 駐車表示(時間経過で解除されない)中にFUNC押下すると、駐車表示を解除し普段通りにモード切替
    - g_parkedDisplayActive=false + 再描画要求
    - 再検知(駐車)で再度詳細表示に戻る
    - ファームウェア 2.0.40
    [bikeclock.h, bikeclock_esp32_keys.ino]
2026-06-22 モーション認識の正規化を固定スケールに変更し推論ログ取得機能を追加
    [推論ログ取得機能]
    - 毎推論(1Hz)の候補・dist・特徴量をBLEでスマホに送信（INFER_LOGコマンドでON/OFF）
    - PC不要で駐車検知の精度分析が可能に。画面で時系列表示・CSV保存
    [正規化方式変更]
    - z-score正規化を固定スケール正規化に変更（FEATURE_SCALE両側で共通定義）
    - 推論ログ分析で、サンプル少＋高再現性でstd過小評価→dist爆発が原因と判明
    - 駐車時のdist 20→0.17に改善、検出精度が格段に向上（実機確認）
2026-06-22 モーション検知レイテンシ改善: 特徴量窓 10秒→2秒・推論周期 1秒→0.5秒
    駐車検知まで約10秒かかっていた問題を解決。特徴量抽出窓をリング
    バッファ全量(10秒)から直近100サンプル(2秒)へ短縮し、駐車動作の
    信号が窓を素早く支配するようにした。推論周期も1秒→0.5秒へ高速化。
    実機で駐車操作後1秒未満での検知・精度向上を確認。
    学習側(Android)もスライド窓で空間整合: 採取10秒(500)を100窓・
    step50(50%重複)で分割し、1採取から最大9学習サンプルを生成。
    MCU:
    - bikeclock.h: MOTION_INFER_INTERVAL_MS 1000→500, MOTION_FEAT_WINDOW_SAMP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
2026-06-22 FUNCキーで通知表示を解除
2026-06-23 モーション認識: 方向付き特徴量(21次元) + クラッシュ修正 + 学習採取4秒化
    特徴量改善:
    - accDynMean → accDynMax/Min（符号付きピーク）で往復動作の方向を保持
    - 駐車-解除の重心距離 0.38→0.91 に改善（方向区別）
    - 学習採取時間 10秒→4秒・リングバッファ論理クリア
    クラッシュ修正:
    - extractFeatures の return true 欠落（真因・未定義動作でスタック破壊）
    - g_motionPatterns をヒープ割当（.bss配置重複回避）
    - saveMotionModel をBLEコールバック外（loop）へ移行
    - logPrint ミューテックス化（マルチタスク安全）
    - updateMotionInference をmotionT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
    [bikeclock.h, bikeclock_esp32.ino, bikeclock_esp32_ble.ino, bikeclock_esp32_imu.ino]
2026-06-23 モーション認識: ラベル構成を9ラベル3グループに再編成
    駐車A/B/C・走行開始A/B/C・停車A/B/C の9ラベルに再編成。
    3パターンを別重心として学習することで、駐車動作のばらつきにロバスト化
    （指紋の複数テンプレートと同じ仕組み）。
    - indexOfLabel は i/3 でグループ番号(0=駐車系,1=走行開始系,2=停車系)を返す
    - ePaper連携・7セグ表示はグループ単位で統一扱い
    - 解除・カーブ・アイドリングは廃止
    - 停車は今後のフェーズ（信号待ちメディア制御）用に確保
2026-06-23 表示モードにモード4を追加し、FUNCモード管理をバインディング表で統一
    - FUNC自動復帰タイムアウトを5秒→10秒に延長
    - 駐車詳細表示に20秒タイムアウトを追加（時刻表示へ自動復帰）
    - FUNC表示モードに統一名(モード1〜4)と FUNC_MODE_TABLE(バインディング表)を導入し、displayModeToEpaperView を表から導出
    - 未使用の EP_VIEW_PARKED を削除
    - モード4追加: 7セグ=秒(SS)表示、ePaper=開始/経過/現在の大型詳細表示(2倍拡大)
    - 駐車検出時のePaper切り替え先をモード3(詳細)→モード4(詳細大)に変更
    - FUNCサイクルを FUNC_MODE_TABLE 走査にリファ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
2026-06-23 駐車検出時に7セグもモード4(秒表示)にする
    駐車オーバーライドは ePaper のみだったため、7セグが時刻のままになり
    モード4(詳細大)と不一致だった。updateDisplayForCurrentMode() の先頭で
    g_parkedDisplayActive を判定し、駐車中は7セグも秒表示にする。
    g_displayMode は触らず表示のみ上書き（ePaperオーバーライドと同方針）。
2026-06-23 モーション学習画面: ラベル単位削除を追加しIMU採取と統合
    ラベル単位削除:
    - 学習データをラベル単位（停車Aなど）で削除できるよう追加
    - 削除時にモデルも未学習化し、古い重心の誤送信を防止＋再学習を促す
    - 確認ダイアログで誤削除を防止
    採取との統合（行き来を解消）:
    - IMU採取画面とモーション学習画面を1画面に統合
    - ImuDataCaptureScreen を ImuCaptureSection に再構築し学習画面へ埋め込み
    - 同一 MotionTrainingRepository シングルトンで採取直後に件数がライブ更新
    - 「IMU採取」単独エントリを廃止し「モーション学習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
2026-06-23 モーション学習: 学習と送信を統合し全削除をデータリスト近くに移動
    学習は一瞬かつ決定的論理でユーザ視点の分離メリットがなかったため、
    train()+sendToMcu() を trainAndSend() に一本化。
    - 「学習してマイコンへ送信」統合ボタン（接続中+サンプルありで有効）
    - 全削除ボタンを学習データリストの直下へ移動
    - 重心表示は送信後に従来通り残す
    - 送信結果フィードバックを model?.let の外に出し未生成時のエラーも表示
2026-06-23 モーション学習画面: セルフタイマー・全画面カウントダウン・ラベル選択統合
    セルフタイマー（開始遅延）:
    - 取得ボタン押下後に 0/5/10/15秒の遅延を選択可能（デフォルト0秒）
    - CaptureState.Countdown 追加、requestDump(delaySec) + beginCapture に分離
    - 取得ボタンの縦幅を拡大（フィールドで押しやすく）
    全画面カウントダウンスプラッシュ:
    - 遅延中は Dialog で画面全体に残り秒数を巨大表示
    ラベル選択の統合（ドロップダウン＋一覧を廃止）:
    - 9ラベルを選択可能な表に統一、行選択が採取/削除の対象
    - selectedLabel を MotionLearni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
2026-06-23 モード4表示刷新とFUNC連打の確実化（v2.0.56）
    モード4 ePaperを「開始日+曜日 / 経過 / 開始〜現在(日またぎ時は24時超え表示)」に変更。FUNC入力をISRからサンプリング統合デバウンスタスク(core0)へ移行し、連打の取りこぼし・過カウントを解消しつつ長押し(メンテナンス)と両立。ePaper描画合成で連打中の無駄な再描画を抑制し、自動復帰タイムアウトのアンダーフロー(g_lastModeChangeMillisをg_currentMillisに統一)も修正。
    [bikeclock.h, bikeclock_esp32.ino, bikeclock_esp32_epaper.ino, bikeclock_esp32_keys.ino]
2026-06-23 IMUの不要な定義削除とモーションモデルパース時のサイズ検証コードを整理
    ・bikeclock_esp32_imu.ino: 使用していない IMU_DUMP_INTERVAL_MS の定義を削除
    ・bikeclock_esp32_motion.ino: parseAndStoreModel 内のサイズ検証用変数 check を廃止し、ポインタ p の積算と検証に統合して簡潔に修正
    [bikeclock_esp32_imu.ino, bikeclock_esp32_motion.ino]
2026-06-24 モード4経過時間表示を時計アイコン+HH:MM形式に変更、走行開始での駐車表示解除を廃止
2026-06-24 通知アクセス権を利用した自動再起動機能を導入 (BTClockMob)
2026-06-24 WiFi OTAをSoftAPモードにした。OTAモード時のQR表示
2026-06-24 Simplify, TODOファイル削除。ドキュメント軽微修正。デバイス履歴日付単位削除
2026-07-23 AGENTS.md新設・CLAUDE.md削除（ルート・bikeclock・bikeclock_esp32）
    - CLAUDE.md を AGENTS.md に一本化（ZCode は AGENTS.md を読むため）
    - ルート AGENTS.md: ファームウェア2種（bikeclock/bikeclock_esp32）の案内
    - bikeclock/AGENTS.md: バージョンbump・ZIP生成のルールを明記
    - bikeclock_esp32/AGENTS.md: バージョンbump・.bin生成・UNIT_NAMEオプションを明記
2026-09-05 TODO.md新設: バイク版温度計統合・自転車用ePaper時計の課題化
2026-09-10 docs: AGENTS.md に親ルール(~/dev/Arduino/AGENTS.md §8 シリアルポート対応表)への参照を追加
2026-09-19 docs: bikeclock/bikeclock_esp32 の書き込み運用をエージェント書込可に変更
    開発用ポート(親§8の212101)への書き込みはエージェントがupload.shを実行してよい(2026-09-19ユーザー決定)。禁止ポート(HIDEF1/HIDPC1/212301)は親§8の保護ルールのまま。両サブプロジェクトのAGENTS.mdから「エージェントは勝手に書き込まない」節を削除したユーザー変更を、親AGENTS.md §4の優先発動に必要な明示宣言として整備。
2026-09-24 docs: TODO.md整理 — 電源方針を意思決定ゲートとして構造化
2026-09-24 docs: TODO整理 — 温度計統合タスクのクローズとダイナモ非搭載を反映
2026-09-25 chore: shebang を /opt/homebrew/bin/bash (5.3) に統一
    bash 3.2 → 5.3.20 移行に伴い、ヘッドレス実行で /bin/bash 3.2 を拾わないよう shebang を絶対パスに変更（機能変更なし）。
2026-09-25 docs: TODO整理 — 電源方針確定(18650直結+振動ウェイク+低電圧通知の乗車時のみ動作モデル・5V UPSブースト不採用・電アシバッテリー給電しない)・残る唯一の判断はXIAO BLE vs ESP32-S3ボード選定(System OFF実測2.4μAの知見でXIAO BLE推奨・実機System OFF電流実測が前提)
2026-09-25 feat: cycleclock v0.1.5 — 自転車用ePaper時計(XIAO BLE)新規追加
    - 18650 BATパッド直結+振動(タクト)ウェイク+System OFF(~μA級)の乗車時のみ動作モデル
    - BLE時刻同期はbikeclockと同一UUID/プロトコル(BTClockMob互換・bonding必須)
    - ePaper描画はbikeclock_esp32(GxEPD2_213_B74)から移植・SPI.setPinsで任意ピン割当
    - スリープ直前に走行スナップショット(日付/乗車時間/走行区間)を描画しゼロ電力保持
    - 起床要因ログ・スイッチ解放待ち(即時起床回避)
2026-09-25 feat: BTClockMob 複数BikeClockデバイスの自動切り替え対応
    接続先未選択時、ペアリング済みBikeClock-全デバイスにスキャンフィルタを
    掛け(ScanFilterリスト=OR条件)、実際に広告しているデバイスへ自動接続する。
    これによりバイク(bikeclock_esp32)と自転車(cycleclock)の切り替えが
    アプリ操作なしで成立する。デバイス選択時は従来どおり1台限定(後方互換)。
2026-09-25 feat: cycleclock v0.2.0 — バッテリー電圧監視(XIAO BLE内蔵分圧・fastrec2方式)
    - cycleclock_battery.ino: VBAT_ENABLE(P0.14)測定時のみ接続しリーク防止
    - 60秒アイドルキャッシュ測定(負荷直後の低め測定回避・fastrec2と同じ分流)
    - GET:batteryプロトコル追加(OK:battery:<mV>・キャッシュ値のみ応答)
    - 分圧比2.96(1510k/510k設計値)はfastrec2校正値を流用
2026-09-25 feat: BTClockMob バッテリー電圧の時系列集計
    - BleDeviceManager.getBattery() (FETCHING_BATTERY操作・旧ファームはERRORで無視)
    - 接続直後+定期同期5回ごと(5分間隔)にGET:battery取得しBatteryLogRepositoryに保存
    - BatteryLogEntry/DataStore(JSONリスト・最大10000件)を追加
    - メイン画面ヘッダーに最新電圧表示(3.5V未満は赤字)
2026-09-25 fix: cycleclock v0.2.2 — 応答の固定長残バイト混入修正+起動直後の電圧即測定
    - sendResponse: setFixedLen(32)特性のnotifyは32バイト全文送信され末尾に
    古いバッファ内容が残る(OK:battery:3689の後に前コマンド断片4508/が付与)
    → 毎回ゼロクリアした全長バッファで送信
    - 起動直後に電圧を即測定(アプリの初回GET:batteryが60秒測定前に来て
    ERRORになる初回失敗を解消)
    [cycleclock.h, cycleclock.ino, cycleclock_battery.ino, cycleclock_ble.ino]
2026-09-25 fix: BTClockMob バッテリー応答の解析を正規表現化+無音失敗のログ化
    固定長特性の応答には残バイトが混入し得るため removePrefix+toIntOrNull
    ではなく Regex(OK:battery:(\\d+)) で抽出。解析失敗時もログを出す
    (今回の無音デバッグ困難の原因)
2026-09-25 feat: cycleclock v0.3.0 — 振動ベーススリープ(BLE接続中でも)+LED短パルス低消費化
    - スリープ条件を「最終振動(スイッチ導通)から3分無し」に変更。BLE接続中は
    先に切断してからSystem OFFする。スマホの位置に依存せず駐輪後は確実に眠る
    (自宅・近距離で接続が維持されるケースを解決)。タクト押下=振動パルス
    - LED: 常時点灯系は超低デューティPWM(約1.2%)、点滅系は2秒に1回50msの
    短パルス(自作キーボード方式・エラー時は500ms間隔)
2026-09-25 docs: 振動ベーススリープの実機動作確認をTODOに記録(3分でスリープ画面→System OFF)
2026-09-25 docs: TODO整理 — 残課題(到着物待ち/v0.2/運用観察)を先頭に再構成、完了済みを日付グループ化
2026-09-25 docs: ソーラー補助充電をTP4056保護付きモジュール構成で具体化(配線はkentoメモ確定版に依存)
2026-09-26 fix: cycleclock v0.3.1 — スリープ画面がBUSY衝突で消えるのを修正(描画前パネルidle待ち)+System OFF前解放待ちタイムアウト
    [cycleclock.h, cycleclock_epaper.ino, cycleclock_power.ino]
2026-09-26 docs: v0.3.1スリープ画面BUSY衝突修正を完了済みへ・電池消費ペース観察(1日1回起動)を残課題に追加
2026-09-27 docs: TP4056到着 — ソーラー組立を実行可能タスク(検品/Rprog判断/ベンチチェック)に展開、kentoメモに組立手順追加
2026-09-27 docs: ソーラー組立の配線完了をTODOに反映 — 残りは組込後実機確認(電圧突合校正・CHRG充電確認)
2026-09-27 feat: cycleclock v0.3.2 — スマホ通知のePaper表示をbikeclock_esp32から移植(MTU247+可変長247B特性・handleNotify・通知ビュー60秒表示)
2026-09-27 docs: v0.3.2通知表示を実機確認済みへ更新(書込直後のX通知がePaperに表示)
2026-09-29 feat: cycleclock v0.3.3-0.3.7 — 低電圧「要充電」表示と電池ピクト5段階を実装
    - v0.3.3: 3.50V以下で「要充電」ビュー(電池アイコン+実測電圧)/3.60V以上で
    解除のヒステリシス。スリープ時は乗車スナップショットの代わりに残画化
    - v0.3.4-0.3.5: 時計・スリープ両画面共用の電池ピクト5段階(3.60-4.10Vを
    0.1V刻み・画面右下固定の縦型)。3.65V未満で警告「!」(解除3.70V)。
    時計は乗車時間を右端206pxへオフセット+時計アイコンをcx90へ移動
    - v0.3.6: パネル物理更新中の測定をスキップ(epaperIdle())。display()が
    BUSYタイムアウト(10s)で先に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
2026-09-29 docs: 低電圧表示v0.3.3-0.3.7の実装・試験結果を反映(閾値スイープ合格・USBスリープ抑止は様子見)
    - 安電源スイープ試験: 3.5V=要充電/3.6-4.1V=1-5本(設計式と0.1V精度内で整合)・
    実18650 3.77V→2本・ePaper書換dipにピクトは反応せず安定
    - 「USB接続中はスリープ不要」要件は一旦取下げ(様子見)・VBUS検知は温存
    - 残課題: v0.3.7書込(実機はv0.3.6)・BATT_DIV_MULT校正
2026-09-29 docs: v0.3.7はユーザーが手動書込済みと訂正(スイープ試験はv0.3.7で実施・書込待ち項目を解消)
2026-09-29 docs: cycleclock READMEの配線を実態に更新(TP4056ソーラー経由の電源配線を追加・MISOダミーはD1に訂正・D0の押下時間役割を追記)
2026-09-29 docs: cycleclock READMEの配線をマイコン起点の1表に統合(ePaper表+その他表+電源表をXIAOピン順の単一マスター表へ)
2026-09-29 docs: READMEのD0行に振動センサー+FUNCキー(押ボタン)の並列接続可を明記(専用GPIO不要・判別は押下時間のみ)
2026-09-29 docs: READMEのD0行を要件どおりに簡潔化(振動センサーとFUNCキー押ボタンをD0-GND間に並列接続=必須・押下時間で動作分担)
2026-09-29 feat: cycleclock v0.3.9 — FUNCキーを専用GPIO(D2)に分離
    v0.3.8の押下時間分離(D0中押し0.5-2s=モード切替)は実機で不採用: クリックで
    反応せず・長押し操作が使いづらい。根本原因は走行中の振動が常にD0へ短押し
    パルスを入れるため「単押し=モード切替」と要件が排他だったこと。波形学習で
    振動/人間を判別する案は論外として、空きGPIOがあるなら分離一択(bikeclockが
    専用FUNCキーSW8を持つのと同じ理由)。
    - D2: FUNCキー押ボタン(他端GND・内部プルアップ)。クリックでモード順送り
    (時計→電池詳細→バージョン)。processFuncKey(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
2026-09-29 feat: cycleclock v0.4.0 — FUNCモードをbikeclock_esp32と同一の4モード構成へ
    ユーザー要件: 「bikeclock_esp32とほぼ一緒に(バッテリーピクト表示を追加した形)」。
    メンテナンスメニュー(FUNC長押し)は不要・電池詳細/バージョンの独立モードは廃止。
    - モード1 時計: 標準(曜日/日付/時刻/乗車時間/電池ピクト)
    - モード2 通知: 最終受信通知の手動選択(未受信は「通知なし」)。
    受信連番 g_notificationSeq で新着時に表示を更新
    - モード3 詳細: 開始/経過/現在日時/電池電圧+ピクト(スナップショット)。
    bikeclock_esp32のHIDキー設定行の代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
2026-09-29 feat: cycleclock v0.4.1 — FUNCキー(D2)でのSystem OFF復帰に対応
    - enterSystemOff のウェイクピンSENSE構成にD2を追加。nRF52のDETECT信号は
    ピンごとのSENSE条件のORのため、D0(振動)とD2(FUNC)のどちらの導通でも起床
    - FUNC押下で起床した場合、起動直後のピン読みで推定し初回releaseをモード
    切替の対象外にする(起こすための押下と切替操作の分離)
    - System OFF前のスイッチ解放待ちをD0/D2両方に拡張(FUNC押しっぱなし放置
    でも即再起床ループを防止・タイムアウト10sは共用)
2026-09-29 docs: v0.4.1の実機確認(バッチリ)を完了済みへ — 残りはBW版ePaper換装とSW-18020P組込の2作業
2026-09-29 feat: cycleclock v0.4.4 — omp整理を取り込み、日跨ぎ走行区間の仕様を原状回復
    omp simplifyの差分をレビューのうえ取り込み(実質改善4件+等価整理):
    - updateTimestamp(): 経過ミリ秒の一括秒加算+端数繰り越し。旧実装は1呼び出し
    最大+1秒・端数毎回破棄のため、3色パネルのフル更新(>10sブロッキング)の
    たびに時計が数秒ずつ遅れて蓄積していた
    - 通知ビューの先頭行にアプリ名を16pxで表示(従来はログ専用)
    - BLE過大Write(>247B)へ "ERROR: Command too long" を応答(旧は無視)
    - BLE切断理由をログに出力
    - デバウンスのDebouncedSwitch共通化・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
    [cycleclock.h, cycleclock.ino, cycleclock_ble.ino, cycleclock_epaper.ino]
2026-10-01 feat: cycleclock v0.4.5 — ePaper表示を180度回転(setRotation 3→1)
2026-10-05 feat: cycleclock v0.4.6 — 日付数字をlogisoso38→46へ拡大・「日」は12pxに縮小し縦線手前へ右端固定配置
    drawKanji16x16Small(最近傍縮小描画)を新設。日付数字をlogisoso38→46へ拡大し視認性向上・「日」は16px→12pxに縮小してDIVIDER_X手前・ベースライン下端の固定配置(2桁日でも数字幅に依存せず重ならない)
2026-10-05 feat: cycleclock v0.4.8 — 振動パルス検出をGPIOTE割り込み化・SW-18020Pの1ms級パルス取りこぼしを解消
    SW-18020Pの導通パルスは1ms級の瞬間導通で、v0.4.6以前の50msデバウンスもv0.4.7のloopポーリング(約10ms)も延長検出を取りこぼしていた(起床はDETECTが拾うがタイマー延長が発火しない)。GPIOTEチャネルFALLINGイベントでハードラッチ検出し、ISRはフラグ設定のみ・タイマー延長とログ出力はloop側で処理。ログはWAKE_PULSE_LOG_INTERVAL_MS(1秒)でレート制限。実機確認済み(2026-10-04・D0 pulseログ確認)。TODO: SW-18020P組込完了・振動パルス検出実機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
2026-10-05 feat: cycleclock v0.4.9 — BLE接続中はスリープしない・D0長押しSystem OFF廃止・System OFF前の解放待ちを無期限化・BW版ePaper前提のタイミング整理(FUNC自動復帰10秒・通知30秒)
2026-10-05 todo整理
2026-10-06 feat: cycleclock v0.4.11 — TPS22810 ePaper電源スイッチ(v0.4.10)・誤起動/短絡統計・通知本文4行化・vibetest/diag ファーム新設
    - v0.4.10: ePaper VCC を TPS22810(D1=旧MISOダミー転用)でGPIO制御。System OFF 電流 0.5mA→11µA(cycleclock_diag で実証)。パネル deep sleep(epaperHibernate)を追加
    - v0.4.11: cycleclock_stats.ino 新設。誤起動回数(BT未接続スタンバイ・InternalFS /fwake.bin 永続化・BT接続スタンバイで0リセット)と D0 短絡回数(BT接続中・RAMのみ)を計測し詳細画面(モード3)に表示
    - 通知ビュー: アプリ名常設行を廃止し本文を y=0 から4行フル描画・本文空時のみ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
2026-10-06 feat: cycleclock v0.4.15 — スリープ判定をBLE接続有無のみに統一(起動/切断後1分でSystem OFF)・振動センサーはSystem OFF復帰専用化・振動検知カウント廃止(v0.4.12-14・誤起動カウントはフラッシュ永続化のまま維持)
2026-10-06 feat: cycleclock v0.4.18 — WS2812B装飾LED追加(v0.4.16・DIN=D6+10kΩプルダウン/VDD=3V3分岐・接続中常亮+起動/通知/低電圧演出)・シリアル調整コマンド(v0.4.18・led/ledsave/leddefault/ledflash/ledinfo・InternalFS永続化)・TPS22810関連記述をコメント/README/TODO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
2026-10-06 refactor: cycleclock v0.4.19 — omp整理: 日付換算をstatic dateCache()に統合(キャッシュ条件・weekday式は動作同等)・FUNCキー処理を関数内デバウスに展開(DebouncedSwitch削除・D0用途v0.4.15廃止に伴う)・ledSavedColor/ledsAllOff抽出(重複除去)・handleGetBattery明示プロトタ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
2026-10-07 cycleclock/README.mdスリム化。todo整理
2026-10-12 feat: BTClockMob v1.2.1 — 乗降ログ書き出し(diary-loc連携)と死リンク検知強制切断
    - 乗降ログ書き出し: RideLogExporter新設。ユーザー指定のSAFツリー(Syncthing共有の
    diary-locを想定)配下 cycleclock/ride-YYYY-MM-DD.jsonl へ乗降イベント
    (conn=乗車/disc=降車/periodic=乗車中定期)を1行JSONL追記(Mac mini日記向け)。
    住所は device_history 記録時に取得済みのものを流用しここではgeocodeしない。
    設定画面にON/OFFスイッチ+書き出し先フォルダ選択(権限失効・再作成後に再選択
    できるよう変更ボタン常時表示)+過去約2週間分の手動一括書き出しを追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
2026-10-12 feat: 通知ページ送り+BLE分割転送 — cycleclock v0.4.23 / BTClockMob v1.3.0
    - cycleclock v0.4.20-22: 通知ビューのページ送り(FUNCクリック・折返し行単位の
    ページ分割+右下「n/m」帯・最終ページで通常動作に合流)。再入判定は専用フラグ
    ep_notifyOnScreen(v0.4.21のep_drawnMode方式はTIMEモード入口で毎パス
    clobberされるため時計上書き表示中に誤動作・実機ログで特定)
    - cycleclock v0.4.23: 通知分割転送(NOTIFY:app=X/<総数> + NOTIFYADD:・RAM組立・
    受信バッファ200B→512B・総数最大8・片方向/Ackなし) + 能力probe GET:features
    (OK:features:notifychunk:512)。非対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
2026-10-18 docs: 廃止開発ポート212101への言及と禁止ポート列挙を現状化（全サブプロジェクト・2026-10-18 USB再編）
2026-10-25 feat: BTClockMob v1.4.4 — RSSIリンク品質管理(接続フィルタ+弱リンク自動切断・gardia_radar移植)
    喫茶店問題(cycleclockはBLE接続があると寝ない)への打ち手として、
    自転車レーダーアプリgardia_radarと同一のRSSI接続/切断制御をアプリ側に実装。
    - 接続時フィルタ: スキャン発見時RSSIが接続しきい値未満なら接続スキップ+再スキャン継続
    - 接続中の自動切断(設定ON/OFF・デフォルトOFF): しきい値未満が判定回数連続でforceDisconnect
    - 設定画面「RSSI設定」(しきい値スライダー×2+判定回数)・MainScreenヘッダーに色分けdBm表示
    - 切断後はbonded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
2026-10-25 docs: RSSI切断の導入動機をTODO.mdに追記(乗降データ精度の実害)
2026-10-26 fix: onScanFailed バックオフを実コメントどおり 5s→10s→20s→30s→30s に修正 — shl 上限の minOf(scanRetryCount,2) では 20s で頭打ちになり maxScanRetryDelay(30s) が到達不能(コメントとコード不一致)。minOf(scanRetryCount,3) へ変更し 4回目以降 40s→30s 上限で動作。転記元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
2026-10-27 fix: BLEスキャン防御を定周期10s再試行+isScanningガードに変更 — 指数バックオフ廃止。未登録状態でのstopScanがスタックのスキャン登録を破壊してerror 2連発で沈黙する問題(v1.4.4/1.4.5でPixel 10実測)への根治・stopScanはスキャン実行中のみ実呼び出しされる
2026-10-27 feat: BTClockMob v1.4.7 — RSSI死リンク検知を追加 — 接続中のonReadRemoteRssi応答が20秒途絶えたらforceDisconnect。範囲外切断ではonConnectionStateChangeが飛ばされConnectedのままRSSI表示が凍結するゾンビ化(v1.4.6実測)を早期検知・RSSI readerの5秒周期ループ内でsilent時間を判定
2026-10-28 fix: v1.4.8 — コードリスクスキャン(2026-10-28)指摘対応 — readRemoteRssi要求失敗の観測性回復+スレッド可視性保証+close済みGATTコールバック無視
    - BleRepository: RSSI readerループでreadRemoteRssi()の戻り値を再チェック(v1.4.7でチェック廃止により要求失敗が無言になり、死リンクタイムアウトの原因が「無応答」か「要求失敗」か区別できなくなっていた)。false時は警告ログのみでループ継続(タイムアウト判定はsilent時間のまま)
    - BleRepository: bluetoothGatt / lastRssiSuccessMs に @Volatile — binderコールバックとIOコルーチンの双方から読み書き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
2026-10-30 feat: BTClockMob v1.4.9+v1.4.10 — 接続先デバイス選択の廃止・自動接続専用化+スキャン停止放置の防御修正 — v1.4.9: プルダウン/設定ラジオ/TARGET_DEVICE_NAME設定キー/BleScanServiceManager.targetDeviceName/bonded直接接続ショートカットを削除し、スキャンフィルタを常に「ペアリング済み全Bike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
2026-10-31 docs: v1.4.9 運用様子見をクローズ — ユーザー判断「再発しなさそう」・v1.4.10 は配信済みで再発時に適用
2026-10-31 docs: 概要の cycleclock ファーム版数を v0.4.19→v0.4.23 に更新 — cycleclock.h 実測(完了済み記録の v0.4.23 と整合)
